Tyler913/LLM_Accelerator/Source/QMAP_FORMAT.md

# QMAP Format

Current status: QMAP v1 is the deployed descriptor contract in the
board-validated full28 design. Its runtime has 281 packets, is packed into 61
verified PL-DDR segments, and is checked for provenance, aperture safety,
non-overlap, and zero initialization of all 397 accelerator-writable regions.
The 2026-08-08 physical board launcher loaded all `61/61` segments, checked all
`281/281` QMAP headers, and reported the exact fixed two-token full28 result
`374 -> 28458 -> 64`, with expected Q26 scores, all 28 layers complete on both
steps, and no reported layer error. Subsequent UART and QWEB prompt-to-text
acceptance is recorded in `Source/CURRENT_STATE.md`.

The preserved 2026-08-01 self-contained package still records release state
`BOARD_TEST_READY_NOT_YET_HARDWARE_VALIDATED`. That value is intentionally
retained as the package's pre-board readiness state; it is not the current
project hardware-validation status. The 2026-08-08 result by itself was a
board PASS for the packaged fixed token-ID smoke; later prompt-to-text evidence
is a separate, stronger validation gate.

Historical progression through 2026-07-13: the dot64 image and the full
row1024 image both passed PS load/readback and PL AXI-master read/compute
hardware smoke tests. The first Layer 0 QKV projection work packet, local PL write-back path,
AXI write adapter, downstream local attention through `o_proj`,
post-attention residual/RMSNorm hookup, MLP gate/up projection, MLP
SiLU/multiply, MLP down projection, and final MLP residual add now pass Icarus
simulation. The full-model current-token final RMSNorm stage also passes
Icarus simulation, and the first tiled Q4 LM-head scan plus greedy argmax stage
passes Icarus simulation for a 1024-row scan window. A memory-backed
LM-head tile reader/wrapper, runtime tile scheduler, and QMAP descriptor-backed
LM-head wrapper now also pass local multi-window scans for `64` and `23`
tiles plus the full `9496`-tile vocabulary sweep. The first QMAP final-token
tail wrapper now composes final RMSNorm write-back with full-vocabulary
LM-head argmax in local RTL/xsim. The first QMAP attention front-end wrapper
now also passes local RTL simulation, reading Q/K/V projection outputs plus
q/k gamma and RoPE tables through descriptors and writing exact K/V cache plus
Q RoPE outputs. The next QMAP attention score/value wrapper now also passes
local RTL simulation, reading Q RoPE plus K/V cache and writing exact
`attn_out[2048]`. The QMAP `o_proj` wrapper now consumes that attention
output, persistent Layer 0 Q4 `o_proj` weight/scale descriptors, and writes
exact `o_proj_out[1024]` locally. The QMAP post-attention residual/RMSNorm
wrapper now consumes residual input, that `o_proj_out[1024]`, and signed
post-attention gamma, then writes exact post-attention hidden and post-norm
buffers locally. The QMAP MLP gate/up wrapper now consumes descriptor-visible
`post_norm[1024]`, persistent Q4 gate/up weight/scale descriptors, and writes
exact gate/up `[3072]` buffers locally for Layer 0 and true Layer 1 packet
instances. The QMAP MLP SiLU/multiply
wrapper now consumes descriptor-visible gate/up `[3072]` plus a fixed UQ0.16
sigmoid LUT and writes exact `mlp_hidden[3072]` locally for Layer 0 and true
Layer 1 packet instances. The QMAP MLP down wrapper now consumes
descriptor-visible `mlp_hidden[3072]`, reads persistent per-layer Q4 down-proj
weight/scale rows, and writes exact `down_out[1024]` locally for Layer 0 and
true Layer 1 packet instances. The QMAP final
MLP residual wrapper now consumes descriptor-visible
`post_attn_hidden[1024]` and `down_out[1024]`, then writes exact
`layer_out[1024]` locally. The first local Layer 0 body scheduler now chains
the QMAP post-attention residual/RMSNorm through final MLP residual wrappers
behind one memory interface and proves exact chained write-back through
`layer_out[1024]`. The wider local Layer 0 scheduler now chains attention
front-end, attention score/value, `o_proj`, and that body scheduler behind one
memory interface, proving exact K/V cache, Q RoPE, attention, `o_proj`, MLP,
and final layer write-back locally. The first local Layer 0 compute scheduler
now runs full QKV projection before that wider scheduler, patches the attention
front-end Q/K/V inputs to the produced Q/K/V output buffers, and proves exact
QKV-through-`layer_out[1024]` write-back locally. The first local
one-token/layer-loop boundary now wraps that Layer 0 compute scheduler with the
future per-layer base-table loop contract, proves the supported Layer 0 case,
proves a focused true Layer 0 -> Layer 1 run with layer done mask `0x3`, and
proves no-memory invalid-table and unsupported-loop exits locally. True Layer 1
QKV projection packets pass the same local AXI-backed write-back contract, the
attention front-end packet passes exact K/V cache plus Q RoPE write-back, the
attention score/value packet passes exact K/V cache reads plus
`attn_out[2048]` write-back, and the true Layer 1 `o_proj` packet passes exact
persistent weight/scale reads plus `o_proj_out[1024]` write-back locally. The
true Layer 1 post-attention residual/RMSNorm packet also passes exact
post-attention hidden and post-norm write-back locally. The true Layer 1 MLP
gate/up and MLP SiLU/multiply packets pass exact gate/up and
`mlp_hidden[3072]` write-back locally, and the true Layer 1 MLP down packet
passes exact persistent row reads plus `down_out[1024]` write-back locally.
The true Layer 1 final MLP residual packet also passes exact
`layer_out[1024]` write-back locally. The reusable one-token top/control
boundary now also passes both the focused Layer 2 scheduler -> final-token tail
xsim run and a stronger Layer 1 -> Layer 2 -> final-token tail xsim run with
one shared memory port, returning token `537` and score `850086863` from the
input-RMSNorm-enabled scheduler-written Layer 2 output. The standalone
per-layer input RMSNorm QMAP wrapper now also passes descriptor-backed local
RTL, reading `hidden[1024]` plus signed `I16_Q8_7` input-layernorm gamma and
writing exact `input_norm[1024]`; the Layer 0 compute scheduler and top have
focused local prechecks showing QKV consuming that wrapper-written activation
buffer. Layer 1 and Layer 2 chained artifacts now include their own input
RMSNorm packets and QKV descriptors that point at those runtime output buffers.

For Q4 quantization semantics, read `Source/Q4_FORMAT.md`. For physical PL
DDR4 placement, read `Source/FPGA_MEMORY_MAP.md`.

## Purpose

QMAP is the project's descriptor-based memory-map format for tensors stored in
PL DDR4. It is designed so the first tiny bring-up case and the later full
model use the same structure:

```text
QMAP header
tensor descriptor table
payload data
```

The first QMAP instances describe real Qwen3 Layer 0 `q_proj` data: first row
0 group 0 as a dot64 vector, then row 0 as a complete row1024 GEMV. The
long-term direction is not to keep making one-off test packets. QMAP should
become the stable descriptor contract between:

- persistent model artifacts stored once in PL DDR4
- runtime work packets that tell PL which tensors to read and which buffers to
  write for the current kernel or token step
- optional debug/golden tensors used only during bring-up

QMAP describes where data is and how to interpret it. It does not define the
math for Q4 itself; that contract stays in `Source/Q4_FORMAT.md`.

## Design Rules

- All multi-byte fields are little-endian.
- All addresses are byte addresses.
- PL DDR4 physical addresses must use 64-bit fields.
- Descriptor and payload addresses should be at least 4-byte aligned.
- Payloads used by future burst readers should be aligned to 64 bytes or
  better when practical.
- Descriptors should describe logical tensor shape separately from physical
  byte size. This matters for packed Q4 weights, where logical shape can be
  `[rows, cols]` while physical row width is `cols / 2` bytes.
- Debug/golden tensors are allowed in QMAP, but they must be marked with a
  debug flag so the future inference path can ignore them.

## Header

The QMAP header lives at the base of a QMAP image. The dot64 test-vector QMAP
image is placed at `0x4_1B10_0000`, the start of the draft PL DDR4 test-vector
staging region. The row1024 test-vector QMAP image is placed at
`0x4_1B20_0000`.

Header size: 256 bytes.

| Offset | Type | Field | Description |
| ---: | --- | --- | --- |
| `0x00` | `u32` | `magic` | ASCII `QMAP`, stored as `0x50414D51` |
| `0x04` | `u32` | `version` | Format version, current value `1` |
| `0x08` | `u32` | `header_bytes` | Current value `256` |
| `0x0C` | `u32` | `descriptor_bytes` | Current value `128` |
| `0x10` | `u32` | `descriptor_count` | Number of valid descriptors |
| `0x14` | `u32` | `descriptor_capacity` | Number of descriptor slots reserved in this image |
| `0x18` | `u64` | `descriptor_table_addr` | Physical address of descriptor table |
| `0x20` | `u64` | `payload_base_addr` | First payload byte address |
| `0x28` | `u64` | `image_base_addr` | Physical base address of the QMAP image |
| `0x30` | `u64` | `image_bytes` | Total bytes occupied by this QMAP image |
| `0x38` | `u32` | `flags` | Image-level flags, initially `0` |
| `0x3C` | `u32` | `checksum32` | Optional checksum over descriptors and payload; `0` if unused |
| `0x40` | `u32[48]` | `reserved` | Must be written as zero |

Bring-up images should reserve eight descriptor slots even if only a few are
valid. This keeps the payload base stable and leaves room for adding an output
or debug descriptor without changing the image shape.

Formal runtime work packets should reserve more descriptor slots from the
start. The first Layer 0 QKV projection packet should use at least 32
descriptor slots, with the payload base moved after the larger descriptor
table. A full persistent model manifest may use hundreds of descriptors.

Recommended first image base:

```text
qmap_base              = 0x4_1B10_0000
descriptor_table_addr  = qmap_base + 0x0100
descriptor_capacity    = 8
payload_base_addr      = qmap_base + 0x0500
```

Recommended second image base:

```text
qmap_base              = 0x4_1B20_0000
descriptor_table_addr  = qmap_base + 0x0100
descriptor_capacity    = 8
payload_base_addr      = qmap_base + 0x0500
```

## Tensor Descriptor

Each tensor descriptor is 128 bytes. Descriptors are fixed-size so PS software
and simple PL readers can index them directly:

```text
descriptor_addr = descriptor_table_addr + tensor_slot * 128
```

| Offset | Type | Field | Description |
| ---: | --- | --- | --- |
| `0x00` | `u32` | `tensor_id` | Stable id inside this QMAP image |
| `0x04` | `u32` | `role` | Tensor role enum |
| `0x08` | `u32` | `dtype` | Data type enum |
| `0x0C` | `u32` | `rank` | Number of valid dimensions in `dims` |
| `0x10` | `u32` | `flags` | Tensor flags |
| `0x14` | `u32` | `element_bits` | Logical element width in bits; use `4` for Q4 logical values |
| `0x18` | `u32` | `group_size` | Q4 group size or `0` if not grouped |
| `0x1C` | `u32` | `scale_tensor_id` | Matching scale tensor id, or `0xFFFF_FFFF` if none |
| `0x20` | `u64` | `base_addr` | Physical byte address of payload |
| `0x28` | `u64` | `nbytes` | Physical payload byte count |
| `0x30` | `u32[4]` | `dims` | Logical tensor dimensions |
| `0x40` | `u64[4]` | `strides_bytes` | Physical byte strides for each logical dimension |
| `0x60` | `u32` | `aux0` | Role-specific metadata, initially matrix id when useful |
| `0x64` | `u32` | `aux1` | Role-specific metadata, initially layer index when useful |
| `0x68` | `u32` | `aux2` | Role-specific metadata, initially row start when useful |
| `0x6C` | `u32` | `aux3` | Role-specific metadata, initially group/column start when useful |
| `0x70` | `u32` | `checksum32` | Optional tensor payload checksum; `0` if unused |
| `0x74` | `u32[3]` | `reserved` | Must be written as zero |

## Role Enum

| Value | Name | Meaning |
| ---: | --- | --- |
| `0` | `QMAP_ROLE_UNUSED` | Unused descriptor slot |
| `1` | `QMAP_ROLE_ACTIVATION` | Activation/input vector |
| `2` | `QMAP_ROLE_Q4_WEIGHT` | Packed Q4 weight tensor |
| `3` | `QMAP_ROLE_Q4_SCALE` | Per-group scale tensor |
| `4` | `QMAP_ROLE_OUTPUT` | Kernel output tensor |
| `5` | `QMAP_ROLE_EXPECTED` | Debug/golden expected tensor |
| `6` | `QMAP_ROLE_METADATA` | Extra metadata payload |
| `7` | `QMAP_ROLE_KV_CACHE` | KV cache tensor |
| `8` | `QMAP_ROLE_ROPE_TABLE` | RoPE cos/sin tensor |
| `9` | `QMAP_ROLE_PARAMETER` | Small read-only model parameter such as RMSNorm gamma or LUT |

## Dtype Enum

| Value | Name | Meaning |
| ---: | --- | --- |
| `0` | `QMAP_DTYPE_UNUSED` | Unused |
| `1` | `QMAP_DTYPE_U8` | Unsigned 8-bit integer |
| `2` | `QMAP_DTYPE_I8` | Signed 8-bit integer |
| `3` | `QMAP_DTYPE_U16` | Unsigned 16-bit integer |
| `4` | `QMAP_DTYPE_I16` | Signed 16-bit integer |
| `5` | `QMAP_DTYPE_U32` | Unsigned 32-bit integer |
| `6` | `QMAP_DTYPE_I32` | Signed 32-bit integer |
| `7` | `QMAP_DTYPE_U64` | Unsigned 64-bit integer |
| `8` | `QMAP_DTYPE_I64` | Signed 64-bit integer |
| `16` | `QMAP_DTYPE_PACKED_Q4_S4` | Two signed int4 values per byte |
| `17` | `QMAP_DTYPE_U16_Q2_14` | Unsigned 16-bit fixed-point `Q2.14` |
| `18` | `QMAP_DTYPE_I16_Q4_12` | Signed 16-bit fixed-point `Q4.12` |
| `19` | `QMAP_DTYPE_I32_Q12_12` | Signed `Q12.12` value padded to 32 bits |
| `20` | `QMAP_DTYPE_I32_Q14_10` | Signed `Q14.10` value padded to 32 bits |
| `21` | `QMAP_DTYPE_U16_Q8_8` | Legacy unsigned `UQ8.8` gamma value |
| `22` | `QMAP_DTYPE_I16_Q8_7` | Signed `Q8.7` gamma value for RMSNorm and q_norm/k_norm |
| `23` | `QMAP_DTYPE_I16_Q1_15` | Signed `Q1.15` value for RoPE cos/sin |
| `24` | `QMAP_DTYPE_U32_Q0_20` | Unsigned `UQ0.20` value padded to 32 bits |
| `25` | `QMAP_DTYPE_U16_Q0_16` | Unsigned `UQ0.16` value padded to 32 bits |

## Tensor Flags

| Bit | Name | Meaning |
| ---: | --- | --- |
| `0` | `QMAP_TENSOR_F_ROW_MAJOR` | Logical tensor is row-major |
| `1` | `QMAP_TENSOR_F_PACKED_Q4_LOW_EVEN` | Even logical Q4 index is stored in low nibble |
| `2` | `QMAP_TENSOR_F_READ_ONLY` | PL should only read this tensor |
| `3` | `QMAP_TENSOR_F_WRITE_ONLY` | PL is expected to write this tensor |
| `4` | `QMAP_TENSOR_F_DEBUG_ONLY` | Debug/golden data, not needed for inference |

## Descriptor Aux Convention

The fixed descriptor fields should be enough for simple PL readers. The `aux`
fields provide a small amount of role-specific metadata without changing the
128-byte descriptor size:

| Field | Default Meaning |
| --- | --- |
| `aux0` | matrix id or tensor-family id |
| `aux1` | layer index |
| `aux2` | row start, head index, or buffer index depending on role |
| `aux3` | group start, column start, or position start depending on role |

Do not make PL depend on descriptor slot number as the semantic meaning. Slot
number is only a table index. Tensor identity comes from `tensor_id`, `role`,
`aux`, and shape metadata.

## Matrix Ids

Matrix ids are optional descriptor metadata used by early software and debug
flows. They are not a replacement for `tensor_id`.

| Value | Name |
| ---: | --- |
| `1` | `q_proj` |
| `2` | `k_proj` |
| `3` | `v_proj` |
| `4` | `o_proj` |
| `5` | `gate_proj` |
| `6` | `up_proj` |
| `7` | `down_proj` |
| `8` | `embed_lm_head` |

## First Instance: Dot64 Smoke

The first QMAP image should describe the real Qwen3 Layer 0
`q_proj` row 0 group 0 dot64 vector from:

```text
artifacts/test_vectors/qwen3_0p6b_q4_v0/q_proj_row0_group0_dot64.npz
```

This image is a minimal descriptor instance, not a special one-off packet.

Recommended placement:

```text
qmap_base      = 0x4_1B10_0000
payload_base   = 0x4_1B10_0500
image_bytes    = 0x0000_0600
```

Descriptor table:

| Tensor Id | Role | Dtype | Shape | Payload Address | Bytes | Notes |
| ---: | --- | --- | --- | ---: | ---: | --- |
| `1` | activation | `I16_Q4_12` | `[64]` | `0x4_1B10_0500` | 128 | activation slice for columns 0..63 |
| `2` | Q4 weight | `PACKED_Q4_S4` | `[1, 64]` logical | `0x4_1B10_0580` | 32 | `q_proj` row 0, group 0 |
| `3` | Q4 scale | `U16_Q2_14` | `[1, 1]` | `0x4_1B10_05A0` | 2 | scale for row 0 group 0 |
| `4` | expected | `I64` | `[2]` | `0x4_1B10_05C0` | 16 | debug-only partial sum and scaled Q26 sum |

For packed Q4 tensors, the innermost logical dimension is sub-byte. In QMAP
v1, set `strides_bytes[0]` to the physical row stride and set the packed
innermost byte stride to `0`; the `PACKED_Q4_S4` dtype plus
`QMAP_TENSOR_F_PACKED_Q4_LOW_EVEN` flag define how logical columns map to
nibbles.

Expected descriptor metadata:

```text
tensor 1:
  aux0 = 1      # q_proj
  aux1 = 0      # layer index
  aux2 = 0      # row start
  aux3 = 0      # group start

tensor 2:
  aux0 = 1      # q_proj
  aux1 = 0
  aux2 = 0
  aux3 = 0
  group_size = 64
  scale_tensor_id = 3

tensor 3:
  aux0 = 1
  aux1 = 0
  aux2 = 0
  aux3 = 0

tensor 4:
  flags includes QMAP_TENSOR_F_DEBUG_ONLY
```

Hardware validation:

- Apps: `qmap_load_smoke_app`, then `qmap_pl_compute_smoke_app`.
- Durable sources:
  `FPGA_Project/software/qmap_load_smoke/` and
  `FPGA_Project/software/qmap_pl_compute_smoke/`.
- Image base: `0x4_1B10_0000`.
- Image size: 1536 bytes / `0x600`.
- Image SHA256:
  `b56319cf576fe8486e3586ee49a4194323cdfe4f4e6208c8b6057e741e5978d4`.
- Result: PS wrote the image into PL DDR4, read it back byte-for-byte, and
  checked the header, four descriptor slots, and selected payload values.
- PL master result: PS loaded the same image, started
  `qmap_dot64_axi_smoke_0`, and PL read the QMAP image from real PL DDR4
  through AXI. The board run reported status `0xA`, partial sum `0x60AF`,
  and scaled Q26 sum `0x2E1366`.

## Second Instance: Row1024 Smoke

The second QMAP image extends the same descriptor structure from one dot64
group to one complete Layer 0 `q_proj` output row. It is still a smoke image,
but it is the first descriptor-driven shape that matches a real GEMV row:

```text
row_sum_q26 =
  sum_group0_to_15(
    sum_j activation[group*64+j] * q4_weight[row, group*64+j]
    * scale_q2_14[row, group]
  )
```

Recommended placement:

```text
qmap_base      = 0x4_1B20_0000
payload_base   = 0x4_1B20_0500
image_bytes    = 0x0000_1000
```

Descriptor table:

| Tensor Id | Role | Dtype | Shape | Payload Address | Bytes | Notes |
| ---: | --- | --- | --- | ---: | ---: | --- |
| `1` | activation | `I16_Q4_12` | `[1024]` | `0x4_1B20_0500` | 2048 | full normalized activation vector |
| `2` | Q4 weight | `PACKED_Q4_S4` | `[1, 1024]` logical | `0x4_1B20_0D00` | 512 | `q_proj` row 0, all 16 groups |
| `3` | Q4 scale | `U16_Q2_14` | `[1, 16]` | `0x4_1B20_0F00` | 32 | one scale per 64-column group |
| `4` | expected | `I64` | `[1]` | `0x4_1B20_0F40` | 8 | debug-only expected row Q26 sum |

Expected descriptor metadata:

```text
tensor 1:
  aux0 = 1      # q_proj
  aux1 = 0      # layer index
  aux2 = 0      # row start
  aux3 = 0      # group start

tensor 2:
  aux0 = 1      # q_proj
  aux1 = 0
  aux2 = 0
  aux3 = 0
  group_size = 64
  scale_tensor_id = 3
  strides_bytes[0] = 512
  strides_bytes[1] = 0

tensor 3:
  aux0 = 1
  aux1 = 0
  aux2 = 0
  aux3 = 0
  strides_bytes[0] = 32
  strides_bytes[1] = 2

tensor 4:
  flags includes QMAP_TENSOR_F_DEBUG_ONLY
```

The row1024 smoke reader must not assume that one tensor fits in one AXI
burst. With a 32-bit AXI data path, the bring-up RTL now fetches the payload in
4-group batches so that the PL does not need to buffer the full 1024-wide row at
once.

Local validation:

- Exporter: `Qwen3-0.6B-Base/python_each_module/20_export_qmap_row1024_image.py`.
- Binary image: `artifacts/test_vectors/qwen3_0p6b_qmap_v1/q_proj_row0_row1024.qmap.bin`.
- Simulation hex:
  `FPGA_Project/sim/vectors/qmap_row1024_image_words32.hex`.
- Image SHA256:
  `2065fb798848e2779847f2b2055bb6ce51b50fd23547e66de43aa758374a917d`.
- Expected row result:
  `row_sum_q26_int64 = -3482169`, low 32-bit word `0xFFCA_DDC7`.
- RTL simulation result:
  `qmap_row1024_compute_path.sv` passed the QMAP-backed row1024 chain.
- AXI simulation result:
  `qmap_row1024_axi_smoke_top.sv` passed with 18 AXI read bursts, status
  `0xA`, and row result `-3482169`.

Hardware validation:

- App: `qmap_row1024_pl_compute_smoke_app` in the clean short-path Vitis
  workspace, with durable source kept under
  `FPGA_Project/software/qmap_row1024_pl_compute_smoke/`.
- Vitis recreation path used for the passing run: short workspace `F:\vws`,
  platform `p_r1024`, application `a_r1024`.
- Image base: `0x4_1B20_0000`.
- Image size: 4096 bytes / `0x1000`.
- Image SHA256:
  `2065fb798848e2779847f2b2055bb6ce51b50fd23547e66de43aa758374a917d`.
- Result: PS wrote the image into PL DDR4, read it back byte-for-byte, and
  checked the QMAP header fields, descriptor table address, payload base, image
  base, and image size.
- PL master result: PS started the row1024 smoke top through the temporary
  control GPIO at `0xA002_0000`; PL read the QMAP image from real PL DDR4
  through AXI and reported status `0xA`. The result GPIO at `0xA003_0000`
  returned `row_sum_q26_low32=0xFFCA_DDC7` and
  `expected_row_sum_q26_low32=0xFFCA_DDC7`, both representing `-3482169`.

## From Smoke Images to Inference Packets

The dot64 and row1024 images proved the descriptor format and the PL AXI read
path. The next step is to use the same descriptor idea for real inference data
movement.

QMAP now has two intended uses:

1. Persistent model manifest
2. Runtime work packet

### Persistent Model Manifest

The persistent model manifest describes tensors that are loaded once into PL
DDR4 and reused across prompt prefill and decode:

- Q4 packed weights and Q2.14 scales for embedding/LM-head, attention
  projections, and MLP matrices
- RMSNorm gamma vectors and q/k norm gamma vectors. Current local RTL keeps
  signed-capable gamma handling for input RMSNorm, post-attention RMSNorm,
  final RMSNorm, and q_norm/k_norm. Layer 1 input RMSNorm gamma includes
  negative values, so unsigned `U16_Q8_8` is not a deployable full-layer
  default.
- optional RoPE cos/sin tables
- fixed base addresses for KV cache, activation buffers, logits/argmax
  scratch, and debug regions

For the full Qwen3-0.6B model, the manifest will likely need hundreds of
descriptors. That is acceptable because descriptor tables are fixed-size and
small compared with model weights. The header `descriptor_capacity` should be
chosen for the artifact, not kept at the bring-up value of eight.

The persistent manifest should not be regenerated per token. PS loads it
during model setup, and PL uses it as the address/shape reference for the
runtime scheduler.

### Runtime Work Packet

A runtime work packet describes one PL task or a small sequence of PL tasks.
It should not duplicate large model weights. It should point at already-loaded
weight, scale, activation, KV-cache, and output-buffer regions using absolute
PL DDR4 addresses in each descriptor.

The current pre-QKV packet is the input RMSNorm runtime packet. The first large
Q4 GEMV runtime packet is the Layer 0 QKV projection packet. Together they are
the bridge from the proven Q4 row1024 GEMV path into the real model datapath:

```text
hidden[1024]
  -> input RMSNorm -> input_norm[1024]
  -> q_proj Q4 GEMV -> q_out[2048]
  -> k_proj Q4 GEMV -> k_out[1024]
  -> v_proj Q4 GEMV -> v_out[1024]
```

The QKV packet should use 32 descriptor slots initially:

```text
descriptor_capacity    = 32
descriptor_table_addr  = qmap_base + 0x0100
payload_base_addr      = qmap_base + 0x1100
```

Only small metadata or optional debug payloads need to live inside the packet
image. Large tensors should live in the normal PL DDR4 weight, activation, or
KV-cache regions and be referenced by descriptor `base_addr`.

### Input RMSNorm Runtime Packet

The input RMSNorm packet produces the normalized activation consumed by QKV.
It closes the pre-QKV layer-stage gap as a descriptor-backed wrapper and is now
integrated as an optional pre-stage in the Layer 0 compute scheduler.

Dataflow:

```text
hidden[1024] + input_layernorm.gamma[1024]
  -> rmsnorm_1024
  -> write input_norm[1024]
```

The current Layer 0 packet base is `0x4_050A_0000`. Layer 1 and Layer 2 chained
artifact packets use `0x4_150A_0000` and `0x4_250A_0000`. Each packet reserves
eight descriptor slots, uses five active descriptors, and uses a compact
self-contained image for local simulation:

```text
descriptor_count       = 5
descriptor_capacity    = 8
descriptor_table_addr  = 0x4_050A_0100
payload_base_addr      = 0x4_050A_0500
image_bytes            = 0x0000_5000
```

Descriptor table:

| Slot | Tensor | Role | Key fields |
| ---: | --- | --- | --- |
| `0` | metadata | `QMAP_ROLE_METADATA` | `U32`, layer/position/debug metadata |
| `1` | hidden input | `QMAP_ROLE_ACTIVATION` | `I32_Q14_10`, `[1024]`, read-only, at `0x4_050A_0540` |
| `2` | input RMSNorm gamma | `QMAP_ROLE_PARAMETER` | `I16_Q8_7`, `[1024]`, read-only, stored as sign-extended 32-bit words at `0x4_050A_1540` |
| `3` | input norm output | `QMAP_ROLE_OUTPUT` | `I32_Q12_12`, `[1024]`, write-only, at `0x4_050A_2540` |
| `4` | expected input norm | `QMAP_ROLE_EXPECTED` | `I32_Q12_12`, `[1024]`, debug-only, at `0x4_050A_3540` |

Local validation:

- Exporter:
  `Qwen3-0.6B-Base/python_each_module/48_export_qmap_input_rmsnorm_image.py`.
- Binary packet:
  `artifacts/test_vectors/qwen3_0p6b_qmap_v1/input_rmsnorm_runtime.qmap.bin`.
- Simulation hex:
  `FPGA_Project/sim/vectors/qmap_input_rmsnorm_image_words32.hex`.
- Expected output hex:
  `FPGA_Project/sim/vectors/qmap_input_rmsnorm_expected_words32.hex`.
- Packet SHA256:
  `59c3243b6cc10856918c307934b9ced8651442c70492ae2fd422cb299b54f64c`.
- RTL wrapper:
  `FPGA_Project/rtl/qmap/compute/qmap_input_rmsnorm_compute_path.sv`.
- Testbench:
  `FPGA_Project/sim/tb_qmap_input_rmsnorm_compute_path.sv`.
- Current signed-gamma Icarus result: exact `1024` input-norm write words, `14` read
  requests, `2224` read-response words, one `4096`-byte output write,
  `sum_squares=589959`, `mean_square=576`, `inv_rms=2796202`, no saturation,
  request/write backpressure coverage, busy-period spurious start coverage,
  and a bad-gamma-dtype no-write error path.
- Trace audit confirms descriptor reads complete before hidden/gamma reads,
  hidden reads complete before gamma reads, gamma reads complete before
  RMSNorm/write-back, all write data completes before done, and the invalid
  descriptor path performs no writes.
- Layer 1 chained artifact generation proved why this packet uses signed gamma:
  `layer1.input_layernorm.weight` contains negative values, so the older
  unsigned `U16_Q8_8` assumption is not valid beyond the Layer 0 bring-up case.

Scheduler integration rule: the QKV activation descriptor must be patched or
generated to read the slot-3 `input_norm[1024]` write-back buffer, not an
exporter-precomputed normalized activation copy. When the activation source is
the RTL RMSNorm output, regenerate QKV golden words with
`21_export_qmap_qkv_projection_image.py --activation-hex` and pass
`--activation-base-addr` so the QKV descriptor itself points to the RMSNorm
output buffer. The old QKV golden was based on the exporter-precomputed
activation and is not the right comparison target for the chained RTL path.

### Layer 0 QKV Projection Packet

The QKV projection packet should describe these tensors:

| Tensor Id | Role | Dtype | Shape | Flags | Notes |
| ---: | --- | --- | --- | --- | --- |
| `1` | metadata | `U32` | implementation-defined | read-only | layer index, selected token position, debug controls |
| `2` | activation | `I32_Q12_12` | `[1024]` | read-only | Layer 0 normalized activation input |
| `3` | Q4 weight | `PACKED_Q4_S4` | `[2048, 1024]` logical | read-only, packed-low-even | Layer 0 `q_proj`; row stride 512 bytes |
| `4` | Q4 scale | `U16_Q2_14` | `[2048, 16]` | read-only | one scale per 64-column group for `q_proj` |
| `5` | Q4 weight | `PACKED_Q4_S4` | `[1024, 1024]` logical | read-only, packed-low-even | Layer 0 `k_proj`; row stride 512 bytes |
| `6` | Q4 scale | `U16_Q2_14` | `[1024, 16]` | read-only | one scale per 64-column group for `k_proj` |
| `7` | Q4 weight | `PACKED_Q4_S4` | `[1024, 1024]` logical | read-only, packed-low-even | Layer 0 `v_proj`; row stride 512 bytes |
| `8` | Q4 scale | `U16_Q2_14` | `[1024, 16]` | read-only | one scale per 64-column group for `v_proj` |
| `9` | output | `I32_Q12_12` | `[2048]` | write-only | Q projection output buffer |
| `10` | output | `I32_Q12_12` | `[1024]` | write-only | K projection output buffer |
| `11` | output | `I32_Q12_12` | `[1024]` | write-only | V projection output buffer |
| `12` | expected | implementation-defined | small spot-check tensor | read-only, debug-only | optional golden words or checksum for bring-up |

Descriptor links:

- tensor `3` uses `scale_tensor_id = 4`
- tensor `5` uses `scale_tensor_id = 6`
- tensor `7` uses `scale_tensor_id = 8`
- output tensors are write-only and must not be used as expected/golden data
- debug tensors must be marked `QMAP_TENSOR_F_DEBUG_ONLY`

The PL QKV projection engine should treat Q, K, and V as the same operation
over different descriptors. The matrix dimensions change, but the row GEMV
contract stays:

```text
for each output row:
  for each group of 64 input elements:
    dot64(input_norm[group], packed_q4_weight[row, group])
    scaled_sum += partial_sum * scale[row, group]
  output[row] = convert_Q26_to_Q12_12(scaled_sum)
  write output[row] to the descriptor-provided output buffer
```

This row loop is part of the real Q/K/V projection, not an additional smoke
test. The critical new hardware capability is write-back through a PL AXI
write path.

Local validation:

- Exporter:
  `Qwen3-0.6B-Base/python_each_module/21_export_qmap_qkv_projection_image.py`.
- Full packet:
  `artifacts/test_vectors/qwen3_0p6b_qmap_v1/layer0_qkv_projection.qmap.bin`.
- Full packet base: `0x4_0008_0000`.
- Full packet size: `0x0022_B000`.
- Full packet row coverage: `q_rows=2048`, `k_rows=1024`, `v_rows=1024`.
- Full packet SHA256:
  `97ce0445a9ba67879ce10093380f5287483550930e4fca2e8c2957ab9d3ea162`.
- Python proof: Q/K/V Q26 recomputation from packed Q4 weights/scales matches
  the source Q4 artifact exactly before Q26-to-I32_Q12.12 conversion.
- Maximum Q12.12 quantization difference versus the Q4 float artifact:
  Q `0.00024390220642089844`, K `0.00024396181106567383`,
  V `0.00024393200874328613`.
- Compact simulation packet:
  `artifacts/test_vectors/qwen3_0p6b_qmap_v1/layer0_qkv_projection_sim.qmap.bin`.
- Compact simulation packet size: `0x0000_4000`.
- Compact simulation row coverage: `q_rows=4`, `k_rows=2`, `v_rows=2`.
- Compact simulation packet SHA256:
  `e50f4294bad3ff852ca18d52bf5013243ec74d5f5779093691bed16a59d09097`.
- Simulation hex:
  `FPGA_Project/sim/vectors/qmap_qkv_projection_image_words32.hex`.
- Expected output hex:
  `FPGA_Project/sim/vectors/qmap_qkv_projection_expected_words32.hex`.
- RTL simulation result:
  `qmap_qkv_projection_compute_path.sv` wrote all compact Q/K/V output words
  and matched Python I32_Q12.12 expected values. The compact run used 33 read
  requests, wrote 8 output rows, and reported no error.
- AXI write adapter result:
  `axi4_write_master.sv` passed a focused 4-beat aligned AXI4 write-burst
  simulation with a valid B-channel response.
- True Layer 1 QKV result:
  `45_export_layer_qkv_q4_vectors.py` exports
  `qkv_layer1_last_token_q4.npz`, and
  `21_export_qmap_qkv_projection_image.py --layer-id 1` emits compact and full
  Layer 1 QMAP packets at `0x4_1008_0000`. The full packet size is
  `0x0022_B000`, covers `q_rows=2048`, `k_rows=1024`, `v_rows=1024`, and the
  AXI smoke top completes `8209` read bursts plus `4096` write bursts with
  status `0xA` and exact Python expected I32_Q12.12 output-word match.
- Chained input-RMSNorm QKV packets:
  `21_export_qmap_qkv_projection_image.py --activation-hex --activation-base-addr`
  now emits packets whose activation descriptor points at the producer
  RMSNorm output buffer while retaining a debug activation payload copy. The
  regenerated Layer 0 packet reads `0x4_050A_2540` and has SHA256
  `9af7ace008d2004318c895fdbc363f6efd39b78f6d7842955d8c6848ab872bb1`; Layer 1
  reads `0x4_150A_2540` with SHA256
  `0b05c61d80108266ce0af74e721f947a597c58caccd6c5e74964d40210409de3`; Layer 2
  reads `0x4_250A_2540` with SHA256
  `4580c10509ba4bed9edab9c72fc2f4150c5812b83aac71a25c7ee76cdad080a1`.

The full self-contained packet at the legacy `0x4_0008_0000` base extends
through `0x4_002A_AFFF`. It overlaps the persistent tied embedding/LM-head
weight region that starts at `0x4_0010_0000`, so the two layouts must not be
loaded concurrently. The legacy base remains useful for isolated QKV
regressions. The continuous token-driven frontend export places the same QMAP
packet contract at non-overlapping test-vector staging base `0x4_1B40_0000`
while keeping tied weights at `0x4_0010_0000`; the RTL consumes the runtime
QMAP base and requires no format change. The fresh XSim regression and
independent timing audit in
`Temp/embedding_layer0_frontend_regression/20260713_131628` match embedding
`1024`, RMSNorm `1024`, and Q/K/V `2048/1024/1024` words exactly under
backpressure.

The same descriptor contract now passes through the complete Layer 0 body.
`51_export_embedding_layer0_full_chain.py` reuses the established per-stage
exporters with a Temp-contained vector workspace, then the shared-memory
testbench patches only consumer `base_addr` fields to the preceding producer
buffers. The audited XSim run in
`Temp/embedding_layer0_full_regression/20260713_135629` checks all 16 write
kinds, exact cache addresses, exact words through final `layer_out[1024]`, and
every producer-response-before-consumer-read boundary. Scheduler traffic is
`46278/2140354` read requests/words and `6155/25600` write requests/words. The
focused scenario intentionally invalidates the final-tail gamma descriptor
after Layer 0 completes, so this result proves the complete layer but does not
claim a new LM-head result.

The current exporter can emit self-contained images for simulation and local
bring-up. In the later persistent-manifest flow, the same descriptors should
point to already-loaded weight, scale, activation, and output-buffer regions
instead of copying large model tensors into every runtime packet.

### Attention Front-End Runtime Packet

The first per-layer body runtime packet starts immediately after QKV projection
write-back. It consumes descriptor-visible Q/K/V buffers, q/k norm gamma, and
RoPE tables, then writes K/V cache entries and a Q RoPE output buffer for the
current token.

Dataflow:

```text
q_out[2048] + k_out[1024] + v_out[1024]
  + q_norm.gamma[128] + k_norm.gamma[128]
  + rope_cos[128] + rope_sin[128]
  -> qk_norm_rope_kv_cache_stage
  -> append K/V cache for one layer/position
  -> write q_rope[2048]
```

The current packet base is `0x4_0502_0000`. It reserves 16 descriptor slots,
uses ten active descriptors, and places the payload after the table at
`qmap_base + 0x0900`.

The same packet format has also been proven with true Layer 1 data at
`0x4_1502_0000`; this is a new packet instance, not a new descriptor format.

Descriptor table:

| Slot | Tensor | Role | Key fields |
| ---: | --- | --- | --- |
| `0` | metadata | `QMAP_ROLE_METADATA` | layer index, position, and debug summary |
| `1` | Q projection output | `QMAP_ROLE_ACTIVATION` | `I32_Q12_12`, `[2048]`, read-only |
| `2` | K projection output | `QMAP_ROLE_ACTIVATION` | `I32_Q12_12`, `[1024]`, read-only |
| `3` | V projection output | `QMAP_ROLE_ACTIVATION` | `I32_Q12_12`, `[1024]`, read-only |
| `4` | q_norm gamma | `QMAP_ROLE_PARAMETER` | `I16_Q8_7`, `[128]`, read-only, padded to 32-bit words in the current packet |
| `5` | k_norm gamma | `QMAP_ROLE_PARAMETER` | `I16_Q8_7`, `[128]`, read-only, padded to 32-bit words in the current packet |
| `6` | RoPE cos | `QMAP_ROLE_ROPE_TABLE` | `I16_Q1_15`, `[128]`, read-only, padded to 32-bit words in the current packet |
| `7` | RoPE sin | `QMAP_ROLE_ROPE_TABLE` | `I16_Q1_15`, `[128]`, read-only, padded to 32-bit words in the current packet |
| `8` | KV cache | `QMAP_ROLE_KV_CACHE` | `I32_Q12_12`, `[2,8,256,128]`, base `0x4_1410_0000` in the current local layout |
| `9` | Q RoPE output | `QMAP_ROLE_OUTPUT` | `I32_Q12_12`, `[2048]`, write-only |

Local validation:

- Exporter:
  `Qwen3-0.6B-Base/python_each_module/37_export_qmap_attention_frontend_image.py`.
- RTL wrapper:
  `FPGA_Project/rtl/qmap/compute/qmap_attention_frontend_compute_path.sv`.
- Testbench:
  `FPGA_Project/sim/tb_qmap_attention_frontend_compute_path.sv`.
- Icarus result: exact `2048` K/V cache write words and exact `2048`
  Q RoPE write words, `31` accepted read requests, `4944` accepted
  read-response words, `2049` accepted write requests, `4096` accepted
  write-data words, deterministic read/write backpressure, busy-period
  spurious start coverage, and an invalid RoPE-cos dtype descriptor path that
  errors with no writes.
- True Layer 1 result: `22_export_qk_norm_rope_fixed_vectors.py`,
  `23_export_kv_cache_append_vectors.py`, and
  `37_export_qmap_attention_frontend_image.py` are now parameterized for Layer
  1 vector prefixes and runtime packet bases. The Layer 1 packet at
  `0x4_1502_0000` uses position `4`, matches all `2048` K/V cache writes and
  all `2048` Q RoPE write-back words, repeats the expected `31` read requests /
  `4944` read-response words and `2049` write requests / `4096` write-data
  words, and trace-audits that cache writes complete before Q RoPE write-back.

### Attention Score/Value Runtime Packet

The next per-layer body packet consumes the Q RoPE output buffer and K/V cache
from the attention front-end path, computes current-token attention scores,
feeds them directly into softmax/value, and writes the attention output before
`o_proj`.

Dataflow:

```text
q_rope[2048] + K cache + V cache + exp_lut[257]
  -> attention_score_stage
  -> attention_softmax_value_stage
  -> write attn_out[2048]
```

The current packet base is `0x4_0503_0000`. It reserves eight descriptor slots,
uses five active descriptors, and places payload data after the table at
`qmap_base + 0x0500`.

The same packet format has also been proven with true Layer 1 data at
`0x4_1503_0000`; this is a new packet instance, not a new descriptor format.

Descriptor table:

| Slot | Tensor | Role | Key fields |
| ---: | --- | --- | --- |
| `0` | metadata | `QMAP_ROLE_METADATA` | `aux0=score_scale_q0_31`, `aux1=layer_id`, `aux2=cache_length`, `aux3=position` |
| `1` | Q RoPE input | `QMAP_ROLE_ACTIVATION` | `I32_Q12_12`, `[2048]`, read-only |
| `2` | K/V cache | `QMAP_ROLE_KV_CACHE` | `I32_Q12_12`, `[2,8,256,128]`, read-only for this packet |
| `3` | softmax exp LUT | `QMAP_ROLE_PARAMETER` | `U32_Q0_20`, `[257]`, read-only |
| `4` | attention output | `QMAP_ROLE_OUTPUT` | `I32_Q12_12`, `[2048]`, write-only |

Local validation:

- Exporter:
  `Qwen3-0.6B-Base/python_each_module/38_export_qmap_attention_score_value_image.py`.
- RTL wrapper:
  `FPGA_Project/rtl/qmap/compute/qmap_attention_score_value_compute_path.sv`.
- Testbench:
  `FPGA_Project/sim/tb_qmap_attention_score_value_compute_path.sv`.
- Icarus result: exact `10240` K-cache reads, exact `10240` V-cache reads,
  exact `2048` `attn_out` write words, `20496` accepted read requests,
  `22961` accepted read-response words, one output write request, `2048`
  accepted write-data words, read/write backpressure coverage, and an invalid
  exp-LUT dtype descriptor path that errors with no writes.
- True Layer 1 result: `24_export_attention_score_vectors.py`,
  `25_export_attention_softmax_value_vectors.py`, and
  `38_export_qmap_attention_score_value_image.py` are now parameterized for
  Layer 1 vector prefixes and runtime packet bases. The Layer 1 packet at
  `0x4_1503_0000` uses position `4`, cache length `5`, writes `attn_out[2048]`
  at `0x4_1503_2980`, matches all `10240` K reads, all `10240` V reads, and
  all `2048` attention-output words, and trace-audits that K reads finish
  before V reads and V reads finish before output write-back.

### Attention Output Projection Runtime Packet

The next per-layer body packet consumes the `attn_out[2048]` buffer written by
the attention score/value wrapper and applies that layer's `o_proj` matrix. The
large `o_proj` Q4 weight and Q2.14 scale tensors are persistent references, not
runtime-packet payload copies.

Dataflow:

```text
attn_out[2048] + persistent o_proj.weight[1024,2048]
  + persistent o_proj.scale[1024,32]
  -> q4_gemv_row_1024(INPUT_SIZE=2048)
  -> write o_proj_out[1024]
```

The current packet base is `0x4_0504_0000`. It reserves eight descriptor slots,
uses six active descriptors, and places payload data after the table at
`qmap_base + 0x0500`.
The same packet format has also been proven with true Layer 1 data at
`0x4_1504_0000`; this is a new packet instance, not a new descriptor format.

Persistent simulation layout:

```text
layer0_o_proj_weight_base = 0x4_0600_0000
layer1_o_proj_weight_base = 0x4_0700_0000
o_proj_weight_row_bytes  = 1024
o_proj_weight_full_bytes = 0x0010_0000
layer0_o_proj_scale_base  = 0x4_0610_0000
layer1_o_proj_scale_base  = 0x4_0710_0000
o_proj_scale_row_bytes   = 64
o_proj_scale_full_bytes  = 0x0001_0000
```

Descriptor table:

| Slot | Tensor | Role | Key fields |
| ---: | --- | --- | --- |
| `0` | metadata | `QMAP_ROLE_METADATA` | `U32`, `aux0=o_proj`, `aux1=layer_id`, `aux2=1024`, `aux3=2048` |
| `1` | attention output input | `QMAP_ROLE_ACTIVATION` | `I32_Q12_12`, `[2048]`, read-only |
| `2` | `o_proj` Q4 weight | `QMAP_ROLE_Q4_WEIGHT` | `PACKED_Q4_S4`, `[1024,2048]`, persistent base from descriptor; default Layer 0 uses `0x4_0600_0000` |
| `3` | `o_proj` Q2.14 scale | `QMAP_ROLE_Q4_SCALE` | `U16_Q2_14`, `[1024,32]`, persistent base from descriptor; default Layer 0 uses `0x4_0610_0000` |
| `4` | `o_proj` output | `QMAP_ROLE_OUTPUT` | `I32_Q12_12`, `[1024]`, write-only |
| `5` | expected output | `QMAP_ROLE_EXPECTED` | `I32_Q12_12`, `[1024]`, debug-only |

Local validation:

- Exporter:
  `Qwen3-0.6B-Base/python_each_module/39_export_qmap_o_proj_image.py`.
- RTL wrapper:
  `FPGA_Project/rtl/qmap/compute/qmap_o_proj_compute_path.sv`.
- Testbench:
  `FPGA_Project/sim/tb_qmap_o_proj_compute_path.sv`.
- Icarus result: exact `1024` Q4 weight-row reads, exact `1024` scale-row
  reads, exact `1024` `o_proj_out` write words, `2070` accepted read requests,
  `280992` accepted read-response words, one output write request, `1024`
  accepted write-data words, request/response/write-data backpressure coverage,
  a busy-period spurious start pulse, and an invalid Q4 weight group-size
  descriptor path that errors with no writes. The CSV trace audit confirms row
  stores run from row 0 through row 1023 before the single output write-back
  burst and that done pulses are not adjacent.
- True Layer 1 result: `26_export_o_proj_vectors.py` and
  `39_export_qmap_o_proj_image.py` are now parameterized for Layer 1 vector
  prefixes, runtime packet bases, and persistent weight/scale bases. The
  Layer 1 packet at `0x4_1504_0000` reads `attn_out[2048]` at
  `0x4_1504_0540`, reads `1024` weight rows from `0x4_0700_0000` through
  `0x4_070F_FC00`, reads `1024` scale rows from `0x4_0710_0000` through
  `0x4_0710_FFC0`, writes exact `o_proj_out[1024]` at `0x4_1504_2540`, and
  repeats the expected `2070` accepted read requests / `280992` accepted
  read-response words plus one output write request / `1024` write-data words.

### Post-Attention Residual/RMSNorm Runtime Packet

The next per-layer body packet consumes the `o_proj_out[1024]` buffer and that
layer's residual stream, applies the post-attention residual add, then applies
post-attention RMSNorm with signed `Q8.7` gamma.

Dataflow:

```text
residual_input[1024] + o_proj_out[1024] + post_attention_gamma[1024]
  -> residual_add_1024
  -> rmsnorm_1024(signed gamma)
  -> write post_attention_hidden[1024]
  -> write post_norm[1024]
```

The current packet base is `0x4_0505_0000`. It reserves and uses eight active
descriptor slots and places payload data after the table at
`qmap_base + 0x0500`. The generated local simulation image is `0x8000` bytes.
The same packet format has also been proven with true Layer 1 data at
`0x4_1505_0000`; this is a new packet instance, not a new descriptor format.

Descriptor table:

| Slot | Tensor | Role | Key fields |
| ---: | --- | --- | --- |
| `0` | metadata | `QMAP_ROLE_METADATA` | `U32`, `aux0=post_attn_residual_norm`, `aux1=layer_id`, `aux2=1024` |
| `1` | residual input | `QMAP_ROLE_ACTIVATION` | `I32_Q14_10`, `[1024]`, read-only |
| `2` | `o_proj` output input | `QMAP_ROLE_ACTIVATION` | `I32_Q12_12`, `[1024]`, read-only, `aux0=o_proj` |
| `3` | post-attention gamma | `QMAP_ROLE_PARAMETER` | `I16_Q8_7`, `[1024]`, read-only, stored as 32-bit words |
| `4` | post-attention hidden | `QMAP_ROLE_OUTPUT` | `I32_Q14_10`, `[1024]`, write-only |
| `5` | post-norm output | `QMAP_ROLE_OUTPUT` | `I32_Q12_12`, `[1024]`, write-only |
| `6` | expected hidden | `QMAP_ROLE_EXPECTED` | `I32_Q14_10`, `[1024]`, debug-only |
| `7` | expected norm | `QMAP_ROLE_EXPECTED` | `I32_Q12_12`, `[1024]`, debug-only |

Local validation:

- Exporter:
  `Qwen3-0.6B-Base/python_each_module/40_export_qmap_post_attention_residual_norm_image.py`.
- RTL wrapper:
  `FPGA_Project/rtl/qmap/compute/qmap_post_attention_residual_norm_compute_path.sv`.
- Testbench:
  `FPGA_Project/sim/tb_qmap_post_attention_residual_norm_compute_path.sv`.
- Icarus result: exact `1024` post-attention hidden write words, exact `1024`
  post-norm write words, `30` accepted read requests, `3616` accepted
  read-response words, two output write requests, `2048` accepted write-data
  words, request/response/write-data backpressure coverage, a busy-period
  spurious start pulse, and an invalid gamma dtype descriptor path that errors
  with no writes. The CSV trace audit confirms the stage-complete snapshot and
  first hidden write request occur in the same cycle, all write data completes
  before done, and normal/bad done pulses are not adjacent.
- True Layer 1 result: `27_export_post_attention_residual_norm_vectors.py`,
  `40_export_qmap_post_attention_residual_norm_image.py`, and
  `qmap_post_attention_residual_norm_compute_path.sv` now accept/validate
  per-layer packet metadata. The Layer 1 packet at `0x4_1505_0000` reads
  residual input at `0x4_1505_0540`, `o_proj_out[1024]` at `0x4_1505_1540`,
  and post-attention gamma at `0x4_1505_2540`; it writes exact
  `post_attention_hidden[1024]` at `0x4_1505_3540` and exact
  `post_norm[1024]` at `0x4_1505_4540`. The run reports
  `sum_squares=75359102`, `inv_rms=247634`, no saturation, and the same
  `30` accepted read requests / `3616` accepted read-response words plus two
  output write requests / `2048` write-data words.

### MLP Gate/Up Runtime Packet

The next per-layer body packet consumes the post-attention RMSNorm output and
computes that layer's MLP gate/up projections from persistent Q4 weight/scale
tensors.

Dataflow:

```text
post_norm[1024]
  + persistent gate_proj.weight[3072,1024] / gate_proj.scale[3072,16]
  + persistent up_proj.weight[3072,1024] / up_proj.scale[3072,16]
  -> two q4_gemv_row_1024 cores in parallel
  -> write gate[3072]
  -> write up[3072]
```

The default Layer 0 packet base is `0x4_0506_0000`. The true Layer 1 packet
base is `0x4_1506_0000`. Both use ten active descriptors, set
`descriptor_capacity=16`, and place payload data after the table at
`qmap_base + 0x0900`. The generated local simulation image is `0xE000` bytes.

Persistent simulation layout:

```text
gate_weight_base       = 0x4_0620_0000
gate_weight_row_bytes  = 512
gate_weight_full_bytes = 0x0018_0000
gate_scale_base        = 0x4_0638_0000
gate_scale_row_bytes   = 32
gate_scale_full_bytes  = 0x0001_8000
up_weight_base         = 0x4_0640_0000
up_weight_row_bytes    = 512
up_weight_full_bytes   = 0x0018_0000
up_scale_base          = 0x4_0658_0000
up_scale_row_bytes     = 32
up_scale_full_bytes    = 0x0001_8000

layer1_gate_weight_base = 0x4_0720_0000
layer1_gate_scale_base  = 0x4_0738_0000
layer1_up_weight_base   = 0x4_0740_0000
layer1_up_scale_base    = 0x4_0758_0000
```

Descriptor table:

| Slot | Tensor | Role | Key fields |
| ---: | --- | --- | --- |
| `0` | metadata | `QMAP_ROLE_METADATA` | `U32`, `aux0=mlp_gate_up`, `aux1=layer_id`, `aux2=3072`, `aux3=1024` |
| `1` | post-norm input | `QMAP_ROLE_ACTIVATION` | `I32_Q12_12`, `[1024]`, read-only |
| `2` | gate Q4 weight | `QMAP_ROLE_Q4_WEIGHT` | `PACKED_Q4_S4`, `[3072,1024]`, persistent base `0x4_0620_0000` |
| `3` | gate Q2.14 scale | `QMAP_ROLE_Q4_SCALE` | `U16_Q2_14`, `[3072,16]`, persistent base `0x4_0638_0000` |
| `4` | up Q4 weight | `QMAP_ROLE_Q4_WEIGHT` | `PACKED_Q4_S4`, `[3072,1024]`, persistent base `0x4_0640_0000` |
| `5` | up Q2.14 scale | `QMAP_ROLE_Q4_SCALE` | `U16_Q2_14`, `[3072,16]`, persistent base `0x4_0658_0000` |
| `6` | gate output | `QMAP_ROLE_OUTPUT` | `I32_Q12_12`, `[3072]`, write-only |
| `7` | up output | `QMAP_ROLE_OUTPUT` | `I32_Q12_12`, `[3072]`, write-only |
| `8` | expected gate | `QMAP_ROLE_EXPECTED` | `I32_Q12_12`, `[3072]`, debug-only |
| `9` | expected up | `QMAP_ROLE_EXPECTED` | `I32_Q12_12`, `[3072]`, debug-only |

Local validation:

- Exporter:
  `Qwen3-0.6B-Base/python_each_module/41_export_qmap_mlp_gate_up_image.py`.
- RTL wrapper:
  `FPGA_Project/rtl/qmap/compute/qmap_mlp_gate_up_compute_path.sv`.
- Testbench:
  `FPGA_Project/sim/tb_qmap_mlp_gate_up_compute_path.sv`.
- Icarus result: exact `3072` gate write words, exact `3072` up write words,
  `12314` accepted read requests, `837280` accepted read-response words, two
  output write requests, `6144` accepted write-data words,
  request/response/write-data backpressure coverage, a busy-period spurious
  start pulse, and an invalid up-scale dtype descriptor path that errors with
  no writes. The CSV trace audit confirms 3072 row completions, gate/up write
  requests at `0x4_0506_1940` and `0x4_0506_4940`, both length 12288 bytes,
  all write data completes before done, and normal/bad done pulses are not
  adjacent.
- True Layer 1 result: with vector prefix
  `layer1_mlp_gate_up_proj_stage_real`, QMAP base `0x4_1506_0000`, and
  persistent gate/up bases `0x4_0720_0000`, `0x4_0738_0000`,
  `0x4_0740_0000`, and `0x4_0758_0000`, Icarus writes exact gate/up
  `[3072]`. Trace audit confirms normal read counts of `qmap=11`,
  `activation=4`, `gate_weight=3072`, `gate_scale=3072`, `up_weight=3072`,
  and `up_scale=3072`, gate/up write requests at `0x4_1506_1940` and
  `0x4_1506_4940`, no unknown reads, zero normal error rows, and no
  invalid-path writes.

### MLP SiLU/Multiply Runtime Packet

This per-layer body packet consumes the MLP gate/up outputs and computes that
layer's MLP activation intermediate.

Dataflow:

```text
gate[3072] + up[3072] + sigmoid_lut[1025]
  -> mlp_silu_mul_stage
  -> write mlp_hidden[3072]
```

The default Layer 0 packet base is `0x4_0507_0000`. The true Layer 1 packet
base is `0x4_1507_0000`. Both use six active descriptors, set
`descriptor_capacity=16`, and place payload data after the table at
`qmap_base + 0x0900`. The generated local simulation image is `0xE000` bytes.
The sigmoid LUT uses unsigned `UQ0.16` values over `[-8, 8]` with `1/64`
spacing; each LUT entry is stored in the low 16 bits of one 32-bit DDR word.

Descriptor table:

| Slot | Tensor | Role | Key fields |
| ---: | --- | --- | --- |
| `0` | metadata | `QMAP_ROLE_METADATA` | `U32`, `aux0=mlp_silu_mul`, `aux1=layer_id`, `aux2=3072`, `aux3=1025` |
| `1` | gate input | `QMAP_ROLE_ACTIVATION` | `I32_Q12_12`, `[3072]`, read-only |
| `2` | up input | `QMAP_ROLE_ACTIVATION` | `I32_Q12_12`, `[3072]`, read-only |
| `3` | sigmoid LUT | `QMAP_ROLE_PARAMETER` | `U16_Q0_16`, `[1025]`, read-only, padded to 32-bit words |
| `4` | hidden output | `QMAP_ROLE_OUTPUT` | `I32_Q12_12`, `[3072]`, write-only |
| `5` | expected hidden | `QMAP_ROLE_EXPECTED` | `I32_Q12_12`, `[3072]`, debug-only |

Local validation:

- Exporter:
  `Qwen3-0.6B-Base/python_each_module/42_export_qmap_mlp_silu_mul_image.py`.
- RTL wrapper:
  `FPGA_Project/rtl/qmap/compute/qmap_mlp_silu_mul_compute_path.sv`.
- Testbench:
  `FPGA_Project/sim/tb_qmap_mlp_silu_mul_compute_path.sv`.
- Icarus result: exact `3072` stage input handshakes, exact `3072` stage
  output handshakes, exact `3072` hidden write words, `43` accepted read
  requests across the normal plus invalid-descriptor runs, `7585` accepted
  read-response words, one output write request, `3072` accepted write-data
  words, request/response/write-data backpressure coverage, a busy-period
  spurious start pulse, and an invalid LUT dtype descriptor path that errors
  with no writes. The normal DUT counters are `36` read requests, `7377`
  read-response words, one write request, and `3072` write words. The CSV trace
  audit confirms the hidden write request at `0x4_0507_7980`, length `12288`
  bytes, all write data completes before done, and normal/bad done pulses are
  not adjacent.
- True Layer 1 result: `29_export_mlp_silu_mul_vectors.py`,
  `42_export_qmap_mlp_silu_mul_image.py`, and the testbench now accept Layer 1
  vector prefixes and runtime QMAP bases. The Layer 1 packet at
  `0x4_1507_0000` consumes true Layer 1 gate/up `[3072]` plus the sigmoid LUT,
  writes exact `mlp_hidden[3072]` at `0x4_1507_7980`, and preserves the same
  `36` normal read requests / `7377` normal response words / one 12288-byte
  output write burst profile. Trace audit confirms normal read counts of
  `qmap=7`, `gate=12`, `up=12`, and `lut=5`, no unknown reads, zero normal
  error rows, no invalid-path writes, and monotonic output progress.

### MLP Down Runtime Packet

The next per-layer body packet consumes the MLP SiLU/multiply hidden output and
computes that layer's MLP down projection from persistent Q4 weight/scale
tensors.

Dataflow:

```text
mlp_hidden[3072]
  + persistent down_proj.weight[1024,3072] / down_proj.scale[1024,48]
  -> q4_gemv_row_1024 with INPUT_SIZE=3072
  -> write down_out[1024]
```

The default Layer 0 packet base is `0x4_0508_0000`. The true Layer 1 packet
base is `0x4_1508_0000`. Both use six active descriptors, set
`descriptor_capacity=16`, and place payload data after the table at
`qmap_base + 0x0900`. The generated local simulation image is `0x6000` bytes.

Persistent simulation layout:

```text
down_weight_base        = 0x4_0660_0000
down_weight_row_bytes   = 1536
down_weight_full_bytes  = 0x0018_0000
down_scale_base         = 0x4_0678_0000
down_scale_row_bytes    = 96
down_scale_full_bytes   = 0x0001_8000

layer1_down_weight_base = 0x4_0760_0000
layer1_down_scale_base  = 0x4_0778_0000
```

Descriptor table:

| Slot | Tensor | Role | Key fields |
| ---: | --- | --- | --- |
| `0` | metadata | `QMAP_ROLE_METADATA` | `U32`, `aux0=mlp_down`, `aux1=layer_id`, `aux2=1024`, `aux3=3072` |
| `1` | MLP hidden input | `QMAP_ROLE_ACTIVATION` | `I32_Q12_12`, `[3072]`, read-only |
| `2` | down Q4 weight | `QMAP_ROLE_Q4_WEIGHT` | `PACKED_Q4_S4`, `[1024,3072]`, persistent base from descriptor; default Layer 0 uses `0x4_0660_0000`, row stride `1536` bytes |
| `3` | down Q2.14 scale | `QMAP_ROLE_Q4_SCALE` | `U16_Q2_14`, `[1024,48]`, persistent base from descriptor; default Layer 0 uses `0x4_0678_0000`, row stride `96` bytes |
| `4` | down output | `QMAP_ROLE_OUTPUT` | `I32_Q12_12`, `[1024]`, write-only |
| `5` | expected down output | `QMAP_ROLE_EXPECTED` | `I32_Q12_12`, `[1024]`, debug-only |

Local validation:

- Exporter:
  `Qwen3-0.6B-Base/python_each_module/43_export_qmap_mlp_down_image.py`.
- RTL wrapper:
  `FPGA_Project/rtl/qmap/compute/qmap_mlp_down_compute_path.sv`.
- Testbench:
  `FPGA_Project/sim/tb_qmap_mlp_down_compute_path.sv`.
- Icarus result: exact `1024` row completions, exact `1024` output write
  words, `3098` accepted read requests across the normal plus invalid-descriptor
  runs, `421280` accepted read-response words, one output write request, `1024`
  accepted write-data words, request/response/write-data backpressure coverage,
  a busy-period spurious start pulse, and an invalid scale dtype descriptor path
  that errors with no writes. The normal DUT counters are `3091` read requests,
  `421072` read-response words, one write request, and `1024` write words. The
  CSV trace audit confirms the down output write request at `0x4_0508_3940`,
  length `4096` bytes, all write data completes before done, and normal/bad
  done pulses are not adjacent.
- True Layer 1 result: with vector prefix `layer1_mlp_down_proj_stage_real`,
  QMAP base `0x4_1508_0000`, and persistent down bases `0x4_0760_0000` and
  `0x4_0778_0000`, Icarus writes exact `down_out[1024]`. Trace audit confirms
  normal read counts of `qmap=7`, `activation=12`, `weight=2048`, and
  `scale=1024`, normal read words of `qmap=208`, `activation=3072`,
  `weight=393216`, and `scale=24576`, the single output write at
  `0x4_1508_3940`, no unknown reads, monotonic `rows_done` through `1024`, and
  an invalid scale-dtype no-write path.

### Final MLP Residual Runtime Packet

The next per-layer body packet consumes the post-attention hidden vector and the
MLP down-projection output, then computes the descriptor-selected layer's final
MLP residual add.

Dataflow:

```text
post_attn_hidden[1024] + down_out[1024]
  -> mlp_residual_add_stage
  -> write layer_out[1024]
```

The default Layer 0 packet base is `0x4_0509_0000`; the true Layer 1 packet
base is `0x4_1509_0000`. The packet uses five active descriptors, sets
`descriptor_capacity=8`, and places payload data after the table at
`qmap_base + 0x0500`. The generated local simulation image is `0x5000` bytes.

Descriptor table:

| Slot | Tensor | Role | Key fields |
| ---: | --- | --- | --- |
| `0` | metadata | `QMAP_ROLE_METADATA` | `U32`, `aux0=mlp_residual_add`, `aux1=layer_id`, `aux2=1024` |
| `1` | post-attention hidden input | `QMAP_ROLE_ACTIVATION` | `I32_Q14_10`, `[1024]`, read-only |
| `2` | MLP down output input | `QMAP_ROLE_ACTIVATION` | `I32_Q12_12`, `[1024]`, read-only |
| `3` | layer output | `QMAP_ROLE_OUTPUT` | `I32_Q14_10`, `[1024]`, write-only |
| `4` | expected layer output | `QMAP_ROLE_EXPECTED` | `I32_Q14_10`, `[1024]`, debug-only |

Local validation:

- Exporter:
  `Qwen3-0.6B-Base/python_each_module/44_export_qmap_mlp_residual_add_image.py`.
- RTL wrapper:
  `FPGA_Project/rtl/qmap/compute/qmap_mlp_residual_add_compute_path.sv`.
- Testbench:
  `FPGA_Project/sim/tb_qmap_mlp_residual_add_compute_path.sv`.
- Icarus result: exact `1024` output words, one `4096`-byte output write
  burst, request/response/write-data backpressure coverage, a busy-period
  spurious start pulse, a bad down-input dtype descriptor path with no writes,
  and a malformed payload `last` protocol path with no writes. The normal DUT
  counters are `14` read requests, `2224` read-response words, one write
  request, and `1024` write words. The full three-run test covers `27` read
  requests and `2577` read-response words. The CSV trace audit confirms the
  layer output write request at `0x4_0509_2540`, length `4096` bytes, all
  write data completes before done, and all error paths complete without
  writes.
- True Layer 1 result: with vector prefix `layer1_mlp_residual_add_stage_real`,
  QMAP base `0x4_1509_0000`, post-attention source
  `qmap_layer1_post_attention_residual_norm`, and down source
  `qmap_layer1_mlp_down`, Icarus writes exact `layer_out[1024]`. Trace audit
  confirms normal read counts of `qmap=6`, `post=4`, and `down=4`, normal read
  words of `qmap=176`, `post=1024`, and `down=1024`, the single output write at
  `0x4_1509_2540`, and bad descriptor/protocol no-write paths.

### Layer 0 Body Scheduler Composition

`FPGA_Project/rtl/qmap/scheduler/qmap_layer0_body_scheduler.sv` is the first local composition
boundary over multiple QMAP per-layer body packets. It does not introduce a new
QMAP packet format. Instead, it sequentially starts the already passing QMAP
wrappers and muxes their memory request/write interfaces onto one local memory
port.

Composition order:

```text
post_attention_residual_norm
  -> mlp_gate_up
  -> mlp_silu_mul
  -> mlp_down
  -> mlp_residual_add
```

The testbench patches downstream descriptor `base_addr` fields so later stages
read actual producer write-back buffers:

```text
post_norm output       -> MLP gate/up activation input
gate/up outputs        -> MLP SiLU/multiply inputs
mlp_hidden output      -> MLP down activation input
post_attn_hidden output -> final MLP residual post-attention input
down_out output        -> final MLP residual down input
```

Local validation:

- RTL scheduler:
  `FPGA_Project/rtl/qmap/scheduler/qmap_layer0_body_scheduler.sv`.
- Testbench:
  `FPGA_Project/sim/tb_qmap_layer0_body_scheduler.sv`.
- Icarus result: the normal chained run completes all five stage bits
  (`stage_done_mask=0x1f`, `stage_error_mask=0x00`) with `15465` read
  requests, `1270961` read-response words, seven output write bursts, and
  `13312` write-data words. The write bursts are post-attention hidden,
  post-norm, gate, up, hidden, down, and final layer output. The final write
  request is `layer_out[1024]` at `0x4_0509_2540`, length `4096` bytes.
- Error validation: corrupting the first-stage gamma dtype descriptor exits
  with `stage_error_mask=0x01`, `stage_done_mask=0x00`, and no writes.
- The CSV trace audit confirms stage order, write addresses, final `done`, and
  no-write-on-error behavior.

### Layer 0 Full Scheduler Composition

`FPGA_Project/rtl/qmap/scheduler/qmap_layer0_full_scheduler.sv` is the first local composition
boundary over the attention-side QMAP wrappers plus the Layer 0 body scheduler.
It still does not introduce a new QMAP packet format. It sequentially starts
the already passing wrappers and muxes their memory request/write interfaces
onto one local memory port.

Composition order:

```text
attention_frontend
  -> attention_score_value
  -> o_proj
  -> qmap_layer0_body_scheduler
```

The testbench patches descriptor `base_addr` fields so consumer packets read
actual producer write-back buffers:

```text
Q RoPE output       -> attention score/value Q input
attn_out[2048]      -> o_proj activation input
o_proj_out[1024]    -> post-attention residual/RMSNorm o_proj input
post_norm[1024]     -> MLP gate/up activation input
gate/up[3072]       -> MLP SiLU/multiply inputs
mlp_hidden[3072]    -> MLP down activation input
post_attn_hidden    -> final MLP residual post-attention input
down_out[1024]      -> final MLP residual down input
```

Local validation:

- RTL scheduler:
  `FPGA_Project/rtl/qmap/scheduler/qmap_layer0_full_scheduler.sv`.
- Testbench:
  `FPGA_Project/sim/tb_qmap_layer0_full_scheduler.sv`.
- Icarus result: the normal chained run completes all four top-level stage bits
  (`stage_done_mask=0xf`, `stage_error_mask=0x0`) and all five body sub-stage
  bits (`body_stage_done_mask=0x1f`, `body_stage_error_mask=0x0`) with
  `38055` read requests, `1579650` read-response words, `2058` write requests,
  and `20480` write-data words.
- Producer write-back coverage: `2048` K/V cache single-word writes,
  `2048` Q RoPE words, `2048` attention output words, `1024` `o_proj` words,
  post hidden/norm `1024/1024`, gate/up `3072/3072`, SiLU hidden `3072`, down
  output `1024`, and final layer output `1024`, all exact against Python
  golden words.
- Error validation: corrupting the first-stage attention front-end descriptor
  exits with `stage_error_mask=0x1`, `stage_done_mask=0x0`, and no writes.
- The CSV trace audit confirms the four top-level stage transitions, exact
  read/write event counts, the `2048` cache write requests, the ten non-cache
  output write requests, normal done, and no-write-on-error behavior.

### Layer 0 Compute Scheduler Composition

`FPGA_Project/rtl/qmap/scheduler/qmap_layer0_compute_scheduler.sv` is the first local
composition boundary that includes the full Layer 0 QKV projection stage. It
does not introduce a new QMAP packet format. It sequentially starts the full
QKV projection packet and the already passing Layer 0 full scheduler, then
muxes both children onto one local memory request/write interface. It now has
an optional `qmap_input_rmsnorm_compute_path.sv` pre-stage ahead of QKV; when
the input RMSNorm QMAP base is nonzero, QKV activation is patched/generated to
consume the wrapper-written `input_norm[1024]` buffer.

Composition order:

```text
optional input_rmsnorm
  -> qkv_projection
  -> qmap_layer0_full_scheduler
```

The testbench reads the Q/K/V output descriptor bases from the QKV projection
packet and patches the attention front-end packet before starting the composed
run:

```text
QKV q_out[2048] -> attention_frontend Q input
QKV k_out[1024] -> attention_frontend K input
QKV v_out[1024] -> attention_frontend V input
```

The downstream descriptor patch chain from the Layer 0 full scheduler is then
preserved unchanged:

```text
Q RoPE output    -> attention score/value Q input
attn_out[2048]   -> o_proj activation input
o_proj_out[1024] -> post-attention residual/RMSNorm o_proj input
post_norm        -> MLP gate/up input
gate/up          -> MLP SiLU/multiply inputs
mlp_hidden       -> MLP down input
down_out         -> final MLP residual input
```

Local validation:

- RTL scheduler:
  `FPGA_Project/rtl/qmap/scheduler/qmap_layer0_compute_scheduler.sv`.
- Testbench:
  `FPGA_Project/sim/tb_qmap_layer0_compute_scheduler.sv`.
- Icarus result: the normal chained run completes both outer stage bits
  (`stage_done_mask=0x3`, `stage_error_mask=0x0`), all four full-scheduler
  stage bits (`layer0_full_stage_done_mask=0xf`,
  `layer0_full_stage_error_mask=0x0`), and all five body sub-stage bits
  (`body_stage_done_mask=0x1f`, `body_stage_error_mask=0x0`). The run covers
  `46264` read requests, `2138130` read-response words, `6154` write
  requests, and `24576` write-data words.
- Producer write-back coverage: QKV writes `2048` Q rows, `1024` K rows, and
  `1024` V rows as single-word row writes. The downstream scheduler then
  writes exact K/V cache, Q RoPE, attention, `o_proj`, post-attention hidden,
  post-norm, gate, up, SiLU hidden, down, and final layer output buffers.
- Error validation: corrupting the QKV activation dtype exits in stage 0 with
  `stage_error_mask=0x1`, `stage_done_mask=0x0`, `13` read requests,
  `400` read-response words, and no writes. Corrupting an attention front-end
  descriptor exits in stage 1 after QKV has completed with
  `stage_done_mask=0x1`, `stage_error_mask=0x2`, `8220` read requests,
  `558816` read-response words, and the expected `4096` QKV writes only.
- The CSV trace audit confirms that the first downstream read from a
  QKV-produced buffer occurs `731` cycles after the final QKV V write request,
  so no downstream consumer reads Q/K/V before the producer stage has completed
  its writes.

### One-Token Layer Scheduler Boundary

`FPGA_Project/rtl/qmap/scheduler/qmap_one_token_layer_scheduler.sv` is the first local wrapper
around the eventual repeated decoder-layer loop. It does not introduce a new
QMAP packet format. Instead, it exposes the loop-control contract that the
future full one-token path needs:

```text
layer_start_index
layer_count
position
input_hidden_base_addr
output_hidden_base_addr
kv_cache_base_addr
per-layer QMAP packet base tables
one shared memory request/write interface
```

The wrapper now iterates over a requested layer range when the corresponding
per-layer table entries are populated. The current data-backed full-compute
evidence is:

```text
single-layer:    layer_start_index = 0, layer_count = 1
true two-layer:  layer_start_index = 0, layer_count = 2
Layer2-only:     layer_start_index = 2, layer_count = 1
```

The previous two-layer alias has been superseded by a focused true Layer 0 ->
Layer 1 run. Layer 0 produces its real final `layer_out[1024]`; the Layer 1
chain then consumes true Layer 1 artifacts and writes exact Layer 1
intermediate and final golden buffers. True Layer 1 QKV Q4 vectors and
compact/full QMAP packets pass the same AXI-backed write-back contract at
`0x4_1008_0000`, the attention front-end slice passes with true Layer 1 Q/K/V,
q/k gamma, RoPE, KV-cache append, and Q RoPE write-back at `0x4_1502_0000`,
and the score/value slice passes with true Layer 1 Q RoPE, K/V cache, exp LUT,
and `attn_out[2048]` write-back at `0x4_1503_0000`; the `o_proj` slice also
passes with true Layer 1 `attn_out[2048]`, persistent `o_proj` Q4
weight/scale, and `o_proj_out[1024]` write-back at `0x4_1504_0000`; the
post-attention residual/RMSNorm slice passes with true Layer 1 residual input,
`o_proj_out[1024]`, post-attention gamma, and exact post-norm write-back at
`0x4_1505_0000`; the MLP gate/up slice passes with true Layer 1
`post_norm[1024]`, persistent gate/up Q4 weight/scale, and exact gate/up
write-back at `0x4_1506_0000`; the MLP SiLU/multiply slice passes with true
Layer 1 gate/up inputs, the fixed sigmoid LUT, and exact `mlp_hidden[3072]`
write-back at `0x4_1507_0000`; the MLP down slice passes with true Layer 1
`mlp_hidden[3072]`, persistent down-proj Q4 weight/scale, and exact
`down_out[1024]` write-back at `0x4_1508_0000`; the final MLP residual slice
passes with true Layer 1 post-attention hidden, true Layer 1
`down_out[1024]`, and exact `layer_out[1024]` write-back at `0x4_1509_0000`.
Out-of-range loop requests and missing selected or ranged base-table entries
exit before any memory request or write data is issued. This keeps the
interface honest while scaling beyond two local layers. The first
multi-layer-output-to-final-tail composition is now proven locally by a
shared-memory scheduler-to-tail xsim run.

The chained-layer artifact flow is now reusable through
`Qwen3-0.6B-Base/python_each_module/47_export_chained_layer_qmap_artifacts.py`.
Layer 2 chained artifacts have been generated from the Layer 1 final
`layer_out[1024]` vector. The Layer 2 QMAP base windows are `0x4_2008_0000`
for QKV and `0x4_2502_0000` through `0x4_2509_0000` for the attention/body
stages; persistent Layer 2 body weight windows use `0x4_0800_0000` through
`0x4_0878_0000`. The current TB has a focused `+l2_only` run that preloads the
Layer 1 output, starts the scheduler at `active_layer=2`, and proves exact
Layer 2 write-back. The AXI-Lite-controlled bounded true three-layer top-to-tail
xsim now also passes with Layer 0 kept on the existing QKV-first golden chain and
Layers 1/2 using input-RMSNorm-enabled QKV artifacts.

The final-token tail packet can now consume chained layer output artifacts as
well. `32_export_final_rmsnorm_vectors.py` accepts a fixed-point Q14.10
`--input-hex`, `35_export_lm_head_full_vocab_vectors.py` accepts a Q12.12
`--activation-hex`, and `36_export_qmap_final_token_tail_image.py` accepts
`--final-norm-prefix`. With the Layer 2 chained `layer_out[1024]` vector as
the final RMSNorm input, the regenerated final-token tail packet uses
`final_rmsnorm_layer2_chained_stage_real` and
`lm_head_argmax_layer2_chained_full_vocab_real`, then passes Vivado xsim with
expected token `537`, expected score `850086863`, all `9496` LM-head tiles, all
`151936` logits, and `max_abs_logit_diff=0`.

The same chained Layer 2 output has now also been consumed directly by the
final-token tail inside one shared-memory scheduler simulation. The focused
`+l2_tail_only` xsim run starts the Layer 2 scheduler, keeps its
`layer_out[1024]` write-back in the memory model, redirects the final-tail
final-hidden descriptor to that buffer, and then runs final RMSNorm plus
full-vocabulary LM-head. The reusable `qmap_one_token_top.sv` boundary now
performs the same sequence inside RTL control using the scheduler-reported last
layer output as the default tail hidden source, with a final-hidden override
left only for debug. The input-RMSNorm-enabled `+l2_top_tail_only` run returns
token `537` and score `850086863`; the newer `+l1_l2_top_tail_only` run starts
Layer 1 and Layer 2 before the tail and returns the same token/score while
proving the final tail selects Layer 2, not the previous layer.

Local validation:

- RTL scheduler:
  `FPGA_Project/rtl/qmap/scheduler/qmap_one_token_layer_scheduler.sv`.
- Testbench:
  `FPGA_Project/sim/tb_qmap_one_token_layer_scheduler.sv`.
- Icarus result: the normal run completes one layer
  (`layers_started=1`, `layers_completed=1`, `layer_done_mask=0x1`,
  `layer_error_mask=0x0`) and preserves the Layer 0 compute totals:
  `46264` read requests, `2138130` read-response words, `6154` write
  requests, and `24576` write-data words.
- Multi-layer loop result: a focused true Layer 0 -> Layer 1 run completes
  (`layers_started=2`, `layers_completed=2`, `layer_done_mask=0x3`,
  `layer_error_mask=0x0`) with exact Layer 1 write-back and aggregate totals
  `92528` read requests, `4276260` read-response words, `12308` write
  requests, and `49152` write-data words.
- Focused Layer 2 result: `+l2_only +fastmem +notrace +progress` now enables
  Layer 2 input RMSNorm and completes at cycle `6700589` with active layer 2,
  `layer_done_mask=0x4`, `46278/2140354` reads, `6155/25600` writes,
  `mismatch_count=0`, `write_mismatches=0`, and `max_abs=0`.
- Layer2-chained final-token tail result: Vivado xsim completes the
  final-RMSNorm plus full-vocabulary LM-head tail with token `537`, score
  `850086863`, `write reqs/words = 2 / 1027`, `norm/output write words =
  1024 / 3`, `tile updates = 9496`, `checked logits = 151936`,
  `max_abs_logit_diff = 0`, and `norm write mismatches = 0`.
- Reusable top/control result: Vivado xsim `+l2_top_tail_only +fastmem
  +progress` completes the Layer 2 input-RMSNorm-enabled scheduler at cycle
  `6700589`, completes the final-token tail at cycle `50800994`, observes
  token `537` and score `850086863`, pulses `scheduler_done=1`,
  `tail_start=1`, `tail_done=1`, and `top_done=1`, reports top counters
  `131772/22807266` reads and `6157/26627` writes, tail read counts
  `4/4/4/75968/9496`, tail writes `1024/3`, and `0` final write mismatches.
- Reusable top/control multi-layer result: Vivado xsim
  `+l1_l2_top_tail_only +fastmem +progress` starts Layer 1 and Layer 2 before
  final-tail launch, completes the scheduler at cycle `13401169`, completes
  the final-token tail at cycle `57501574`, observes token `537` and score
  `850086863`, pulses `scheduler_done=1`, `tail_start=1`, `tail_done=1`, and
  `top_done=1`, reports layer done mask `0x6`, top counters
  `178050/24947620` reads and `12312/52227` writes, tail read counts
  `4/4/4/75968/9496`, tail writes `1024/3`, and `0` final write mismatches.
- MMIO-style control result: `qmap_one_token_control_regs.sv` now defines the
  local software-visible register contract for start/clear, scalar config,
  packet-base table commit, sticky status, output token/score, layer masks,
  last output/tail hidden base, and counters. Vivado xsim
  `+l1_l2_mmio_top_tail_only +fastmem +notrace +progress` launches the same
  Layer 1 -> Layer 2 -> final-tail path through register writes and completes
  with scheduler done cycle `13401430`, tail done cycle `57501835`, token
  `537`, score `850086863`, layer done mask `0x6`, tail hidden and last-layer
  output both `0x4_2509_2540`, top counters `178050/24947620` reads and
  `12312/52227` writes, tail writes `1024/3`, and `0` final write mismatches.
  This xsim proof still uses the tiny valid/ready MMIO-style contract directly;
  the AXI4-Lite wrapper now sits above the same register contract rather than
  changing any QMAP packet semantics.
- Productized wrapper smoke result: `qmap_one_token_mmio_top.sv` instantiates
  `qmap_one_token_control_regs.sv` and `qmap_one_token_top.sv` together. The
  focused Icarus testbench `tb_qmap_one_token_mmio_top.sv` drives the register
  port, starts an intentionally invalid `layer_count=0` request, observes a
  quick scheduler validation exit, reads sticky status/layer-error/counters
  back through the same register port, and proves no memory traffic is issued.
- AXI-Lite wrapper smoke result: `axi4lite_to_mmio_regs.sv` now serializes
  32-bit AXI4-Lite reads/writes into that tiny register port with focused
  AW/W ordering, stall, local reject, and downstream error coverage in
  `tb_axi4lite_to_mmio_regs.sv`. `qmap_one_token_axil_top.sv` wraps the adapter
  around `qmap_one_token_mmio_top.sv`, and `tb_qmap_one_token_axil_top.sv`
  passes the same invalid `layer_count=0` no-memory validation path through
  AXI-Lite writes/reads while preserving sticky status, layer-error, counter,
  and clear behavior. The AXI-Lite wrapper now also passes the positive
  Layer1 -> Layer2 -> final-tail xsim memory-model path through register
  writes/reads: scheduler done cycle `13402176`, tail done cycle `57502581`,
  token `537`, score `850086863`, layer mask `0x6`, top counters
  `178050/24947620` reads and `12312/52227` writes, tail writes `1024/3`, and
  `0` final write mismatches. QMAP packet/image layout is unchanged by this
  control adapter.
- Historical mixed AXI-Lite bounded three-layer baseline: the same productized
  wrapper now launches Layer 0(QKV-first) -> Layer 1 -> Layer 2 -> final-tail
  through AXI-Lite register writes/reads under `+true3_mmio_top_tail_only` plus
  `+fastmem +notrace +progress`. It completes with scheduler done cycle
  `20095284`, tail done cycle `64195689`, token `537`, score `850086863`, layer
  mask `0x7`, scheduler counters `138820/6418838` reads and `18464/75776`
  writes, top counters `224314/27085750` reads and `18466/76803` writes, tail
  writes `1024/3`, and `0` final write mismatches. Layer 0 is intentionally
  QKV-first in this older baseline.
- Continuous token-driven three-layer result: Layer 0 input-RMSNorm artifacts
  now exist, and `52_export_embedding_true3_final_chain.py` propagates the tied
  Q4 embedding output through complete Layers 0, 1, and 2 before regenerating
  final RMSNorm and the full-vocabulary tail. The AXI-Lite regression
  `Temp/embedding_true3_axil_tail_regression/20260713_145056` passes exact golden
  comparison with token/score `537/838805253`, scheduler counters
  `138834/6421062` reads and `18465/76800` writes, and aggregate top counters
  `224330/27088110` reads and `18468/78851` writes. Its independent event audit
  proves embedding response before Layer 0 reads, each layer output response
  before the next layer reads, and Layer 2 response before scheduler-done,
  tail-start, and final hidden reads. Layer 0 QKV is staged at `0x4_1B40_0000`
  so the persistent tied table remains at `0x4_0010_0000` without overlap.
- Continuous token-driven 28-layer result:
  `53_export_embedding_full28_final_chain.py` applies the same QMAP contract to
  every model layer and emits `full_chain_manifest.json` plus a physical address
  audit. The integrated layout keeps tied weights/scales at
  `0x4_0010_0000`/`0x4_04B3_0000`, uses layer block base `0x4_0500_0000` with
  `0x0084_0000` stride, body-QMAP base `0x4_1790_0000` with 1 MiB stride,
  per-layer KV cache from `0x4_1410_0000` with 2 MiB stride, and final-tail QMAP
  base `0x4_1950_0000`. The `508` audited intervals occupy
  `0x4_0010_0000..0x4_1950_3fff`, remain inside PL DDR, and do not overlap.
- `run_embedding_full_chain_axil_tail_regression.ps1` converts that manifest into
  a generated Temp-only SystemVerilog include, then runs the generic shared-memory
  testbench through AXI-Lite. Session
  `Temp/embedding_full28_axil_tail_regression/20260713_164001` passes all 28
  complete layers and the full-vocabulary tail with exact layer mask
  `0x0fffffff`, token/score `537/1155032971`, scheduler counters
  `1295784/59929912` reads and `172340/716800` writes, and aggregate counters
  `1381280/80596960` reads and `172343/718851` writes. The independent streamed
  event audit observes all `281` QMAP packets, all 28 layer responses, exact
  write-kind/address/data counts, and strict response-before-consumer ordering;
  `top_done` occurs at cycle `231727944` with zero mismatch/error events.
- PS-side register/runtime skeleton: `FPGA_Project/software/qmap_one_token_runtime/`
  now mirrors the control register offsets and table ids, including optional
  input-RMSNorm table commits, so the continuous Layer0/Layer1/Layer2 QMAP
  contract can be represented by software before the Vivado BD base address is
  assigned. `qmap_one_token_axi_top.sv` now provides the first Vivado-facing
  shell for that software contract by adapting the existing local memory port to
  AXI4 read/write masters; `tb_qmap_one_token_axi_top.sv` proves its no-memory
  validation path without issuing AXI4 memory traffic.
- Exact write-back coverage now spans the Layer 0 QKV-first path plus chained
  Layer 1 and Layer 2 packet/cache/weight windows: Q/K/V projection, K/V cache,
  Q RoPE, attention output, `o_proj`, post-attention hidden/norm, MLP gate/up,
  SiLU hidden, down output, and final `layer_out[1024]` all match the Python
  golden words in the covered local RTL paths.
- Error validation: QKV-stage invalid activation dtype and later attention
  front-end invalid descriptor paths propagate through the loop wrapper with
  the expected layer masks. A missing selected Layer 0 QKV base-table entry, a
  missing Layer 1 packet-base entry for a two-layer request, and out-of-range
  `layer_start_index=28` all exit with no read requests, no read responses, no
  write requests, and no write data. A separate validation-only testbench also
  covers zero `layer_count` and zero input-hidden base as no-memory exits.
- Progress output confirms the true two-layer run advances from active layer 0
  to active layer 1 after Layer 0 completes, then finishes with zero
  mismatches. Layer 1 unit traces are emitted for chained score/value,
  `o_proj`, post-attention residual/RMSNorm, MLP gate/up, MLP SiLU/multiply,
  MLP down, and final MLP residual-add runs.
- Trace audit for the Layer2-chained final-token tail confirms final hidden and
  gamma reads complete before final_norm writes, final_norm/weight/scale reads
  start only after the 1024-word final_norm write-back completes, token/score
  output writes occur after all LM-head tile reads, and `done` follows the
  output write.
- Trace audit for the shared scheduler-to-tail run confirms final-hidden reads
  start after scheduler completion, final_norm reads start after final_norm
  write-back, LM-head weight/scale reads complete before output writes, and the
  output write finishes before tail `done`.
- Trace audit for the reusable top/control run
  `qmap_one_token_top_layer2_input_norm_to_final_tail_trace.csv` has `307615`
  data rows and confirms tail state starts at cycle `6700591`, hidden reads start
  at `6701175` after scheduler completion, final-norm write-back completes at
  `6708411`, norm reads start at `6709001`, LM-head weight reads start at
  `6711056`, output write request/data runs at `50800983..50800986`, and top
  `done` follows
  at `50800996`.
- Trace audit for the reusable top/control multi-layer run
  `qmap_one_token_top_layer1_layer2_input_norm_to_final_tail_trace.csv` has
  `444228` data rows and confirms Layer 1 output write-back completes at cycle
  `6700579` before Layer 2 reads that buffer at cycle `9967557`, Layer 2 output
  write-back completes at cycle `13401159` before final-tail hidden reads begin
  at cycle `13401755`, final-norm write-back completes at cycle `13408995`
  before norm reads begin at cycle `13409581`, output write request/data runs
  at `57501563..57501566`, and top `done` follows at cycle `57501576`.

### LM-head Memory-Backed Scan Contract

The first LM-head memory-facing path uses the tied embedding/LM-head table as a
Q4 weight matrix with one Q2.14 scale per 64 columns. The current local vector
exporters are:

```text
Qwen3-0.6B-Base/python_each_module/33_export_lm_head_argmax_vectors.py
Qwen3-0.6B-Base/python_each_module/35_export_lm_head_full_vocab_vectors.py
```

The exported layout keeps full-vocabulary base addresses even when the local
testbench loads only the `[0,1024)` scan window:

```text
lm_head_weight_base       = 0x4_0010_0000
lm_head_weight_row_bytes  = 512
lm_head_weight_full_bytes = 0x04A3_0000
lm_head_scale_base        = 0x4_04B3_0000
lm_head_scale_row_bytes   = 32
lm_head_scale_full_bytes  = 0x004A_3000
```

`lm_head_tile_mem_reader.sv` reads one 16-row tile as eight 1024-byte packed-Q4
weight bursts plus one 512-byte scale burst. `lm_head_argmax_mem_stage.sv`
wraps that reader around `lm_head_argmax_stage.sv` without changing the argmax
core. The local memory-model testbench passes for two complete 1024-row scans:
`1152` read requests, `278528` response words, `2048` checked logits, exact
token `264`, exact score `1365150750`, and no error cycles.

`lm_head_argmax_tile_scheduler.sv` reuses that memory-backed stage as a
one-tile child engine and keeps the global best token/score across runtime tile
windows. Its default capacity is `MAX_TILES=9496`, matching the full
`151936`-row vocabulary at 16 rows per tile. The current local scheduler
testbench proves two runtime scan counts: `64` tiles for the existing
1024-row window and `23` tiles for a 368-row prefix. It matches exact token
`264`, exact score `1365150750`, and `1392` checked logits with
`max_abs_logit_diff=0`.

`34_export_qmap_lm_head_argmax_image.py` exports QMAP runtime packets for this
path. The packet base is `0x4_0500_0000`, uses six active descriptors, and
keeps the large LM-head weights/scales as persistent tensor references instead
of copying them into the runtime packet. The same descriptor contract is used
for the compact `[0,1024)` scan and the full `[0,151936)` vocabulary scan:

| Slot | Tensor | Role | Key fields |
| ---: | --- | --- | --- |
| `0` | metadata | `QMAP_ROLE_METADATA` | scan metadata and debug summary |
| `1` | final RMSNorm output | `QMAP_ROLE_ACTIVATION` | `I32_Q12_12`, `[1024]`, read-only |
| `2` | LM-head Q4 weight | `QMAP_ROLE_Q4_WEIGHT` | `PACKED_Q4_S4`, `[151936,1024]`, `aux2=scan_base`, `aux3=tile_count` |
| `3` | LM-head Q2.14 scale | `QMAP_ROLE_Q4_SCALE` | `U16_Q2_14`, `[151936,16]`, same scan aux fields |
| `4` | output token/score | `QMAP_ROLE_OUTPUT` | three `U32` words: token, score low32, score high32 |
| `5` | expected token/score | `QMAP_ROLE_EXPECTED` | debug-only copy of the three output words |

`qmap_lm_head_argmax_compute_path.sv` validates those descriptors, reads the
final RMSNorm activation, runs the scheduler, and writes
`{token, score_low32, score_high32}` to the output descriptor. Its testbench
covers descriptor-provided `64`-tile and `23`-tile scans, plus an invalid
`tile_count=0` descriptor that must raise error and perform no output write.
The compact Icarus run reports token `264`, score `1365150750`, `812` read
requests, `191984` response words, `1392` checked logits, and
`max_abs_logit_diff=0`. The full-vocabulary Vivado xsim run uses
`QMAP_LM_HEAD_TB_FULL_VOCAB` and reports `9496` tiles, `151936` checked logits,
`85475` read requests, `20664528` response words, one output write burst,
token `264`, score `1365150750`, and `max_abs_logit_diff=0`.

### Final-Token Tail Runtime Packet

The first composed one-token tail packet adds final RMSNorm in front of the
descriptor-backed LM-head scan. It is intentionally still a runtime packet, not
a persistent manifest. The packet base is `0x4_0501_0000`, uses eight active
descriptors, and keeps the large LM-head weights/scales as persistent tensor
references.

Dataflow:

```text
final_hidden[1024] + final_norm.gamma[1024]
  -> final_rmsnorm_stage
  -> write final_norm[1024] to the QMAP activation descriptor
  -> qmap_lm_head_argmax_compute_path
  -> write output token/score descriptor
```

Descriptor table:

| Slot | Tensor | Role | Key fields |
| ---: | --- | --- | --- |
| `0` | metadata | `QMAP_ROLE_METADATA` | tail metadata and debug summary |
| `1` | final-norm scratch / LM-head activation | `QMAP_ROLE_ACTIVATION` | `I32_Q12_12`, `[1024]`, written by final RMSNorm then read by LM-head |
| `2` | LM-head Q4 weight | `QMAP_ROLE_Q4_WEIGHT` | `PACKED_Q4_S4`, `[151936,1024]`, `aux2=scan_base`, `aux3=tile_count` |
| `3` | LM-head Q2.14 scale | `QMAP_ROLE_Q4_SCALE` | `U16_Q2_14`, `[151936,16]`, same scan aux fields |
| `4` | output token/score | `QMAP_ROLE_OUTPUT` | three `U32` words: token, score low32, score high32 |
| `5` | expected token/score | `QMAP_ROLE_EXPECTED` | debug-only copy of the three output words |
| `6` | final hidden input | `QMAP_ROLE_ACTIVATION` | `I32_Q14_10`, `[1024]`, read-only |
| `7` | final RMSNorm gamma | `QMAP_ROLE_PARAMETER` | `I16_Q8_7`, `[1024]`, read-only signed gamma padded to 32-bit words in the current packet |

Local validation:

- Exporter:
  `Qwen3-0.6B-Base/python_each_module/36_export_qmap_final_token_tail_image.py`.
- RTL wrapper:
  `FPGA_Project/rtl/qmap/compute/qmap_final_token_tail_compute_path.sv`.
- Testbench:
  `FPGA_Project/sim/tb_qmap_final_token_tail_compute_path.sv`.
- Compact Icarus result: `64` LM-head tiles, token `264`, score
  `1365150750`, `1024` exact final-norm write words, `1024` checked logits,
  `max_abs_logit_diff=0`, invalid gamma descriptor error path covered, and no
  stale best-result exposure.
- Full-vocabulary Vivado xsim result: `9496` tiles, `151936` checked logits,
  token `264`, score `1365150750`, `1024` final-norm write words, `3`
  token/score output words, `max_abs_logit_diff=0`, one done pulse, and zero
  error/saturation rows in the trace audit.

## Full-Model Runtime Write-Back Policy

For correctness-first inference, these runtime values should be writable in PL
DDR4, even if later optimized versions keep some of them on chip:

| Tensor Family | Shape | Suggested Dtype | Write Policy |
| --- | --- | --- | --- |
| hidden ping-pong buffers | `[1024]` | `I32_Q14_10` or `I32_Q12_12` by stage | write after embedding/layer output |
| RMSNorm output | `[1024]` | `I32_Q12_12` | QMAP input RMSNorm wrapper writes exact projection input locally; one-token scheduler prechecks cover Layer 0/1/2 RMSNorm output feeding QKV, and focused Layer 1/2 full-layer runs now use that input-normalized activation contract |
| Q projection output | `[2048]` | `I32_Q12_12` | write for q_norm/RoPE input |
| K projection output | `[1024]` | `I32_Q12_12` | write for k_norm/RoPE input |
| V projection output | `[1024]` | `I32_Q12_12` | write for KV-cache append |
| post-RoPE K cache | `[28, 8, T, 128]` | `I32_Q12_12` | append one position per layer/token |
| V cache | `[28, 8, T, 128]` | `I32_Q12_12` | append one position per layer/token |
| attention output before `o_proj` | `[2048]` | `I32_Q12_12` | QMAP score/value wrapper now writes exact `attn_out[2048]` locally |
| `o_proj_out` | `[1024]` | `I32_Q12_12` | QMAP `o_proj` wrapper now writes exact output locally |
| post-attention hidden | `[1024]` | `I32_Q14_10` | QMAP post-attention wrapper writes and validates this residual result before post-attention RMSNorm |
| MLP gate/up outputs | `[3072]` each | `I32_Q12_12` | QMAP MLP gate/up wrapper now writes exact gate/up buffers locally |
| MLP SiLU/multiply intermediate | `[3072]` | `I32_Q12_12` | QMAP MLP SiLU/multiply wrapper now writes exact hidden locally; this is the MLP down-projection input |
| MLP down output | `[1024]` | `I32_Q12_12` | QMAP MLP down wrapper now writes exact down output locally; this is the final MLP residual input |
| layer output | `[1024]` | `I32_Q14_10` | QMAP final MLP residual wrapper now writes exact layer output locally; this is the next layer input |
| final RMSNorm output | `[1024]` | `I32_Q12_12` | local RTL final-norm stage passes; LM-head input |
| logits/argmax scratch | tiled | implementation-defined | local RTL tiled argmax core, memory-backed 1024-row wrapper, runtime tile scheduler, QMAP descriptor wrapper, and full-vocab QMAP LM-head scan pass; writes final token id and token score |

Do not require all of these tensors to be stored forever. The rule is that a
formal packet must make every consumed or produced tensor explicit. Later RTL
can replace DDR write-back with streaming or on-chip buffering only after the
descriptor-level contract is clear.

The PL reader and scheduler should therefore be designed around descriptors and
tensor ids, not around a hard-coded 256-byte packet.

## Current Full28 Board Runtime

The first board-deployable QMAP runtime is generated from the complete
28-layer manifest, then packed by
`Qwen3-0.6B-Base/python_each_module/57_pack_qmap_runtime_load_plan.py`.

Release contract:

| Property | Value |
| --- | ---: |
| layer count | `28` |
| per-layer packets | `10` |
| final-tail packets | `1` |
| total QMAP headers | `281` |
| binary load segments | `61` |
| total segment bytes | `394,547,200` |
| first loaded address | `0x4_0010_0000` |
| last end-exclusive address | `0x4_1A14_0000` |
| PL DDR aperture | `0x4_0000_0000..0x4_1FFF_FFFF` |
| accelerator-writable zero regions | `397` |

The segment manifest carries SHA256 values for every binary plus SHA256
provenance for the source load plan and complete full-chain manifest. The
release audit reconstructs interval ownership, rejects overlaps or any byte
outside PL DDR, and requires the XSDB loader to contain exactly one
`dow -data -bypass-cache-sync` operation per segment. Bypassing cache
synchronization is part of the loader contract because these physical writes
target PL DDR while Cortex-A53 #0 is halted; XSDB must not attempt A53 cache
maintenance after each data chunk. The packaged launcher uses
`name =~ "PL"` as the default `QOT_DEVICE_FILTER` for selecting the FPGA to
program, while still allowing an explicit filter override when multiple JTAG
devices are present. The release audit also compares all 280 per-layer QMAP
bases and eight global addresses compiled into the Vitis model application
against that exact full-chain manifest.

QMAP-header coverage is:

```text
28 * (
  qkv + input_rmsnorm + attention_frontend + attention_score_value +
  o_proj + post_attention_norm + mlp_gate_up + mlp_silu_mul +
  mlp_down + mlp_residual_add
) + final_tail = 281
```

The 397 zero-initialized regions are deliberate:

```text
28 layers * 14 stage-output regions = 392
+ 1 complete KV-cache region
+ hidden A
+ hidden B
+ final norm scratch
+ final token/score output
= 397
```

The single cache interval covers all 28 layer slices. QMAP packets, Q4
weights/scales, gamma/LUT/RoPE inputs, and immutable metadata are loaded;
produced activations, cache entries, and final outputs are not preloaded with
golden values. This is a release-level anti-false-positive rule.

The packaged board launcher waits for DDR status `0x5`, loads all 61 segments
with cache synchronization bypassed, and reads the magic at all 281 packet
bases before starting the model ELF. Passing these checks proves that the
intended runtime was loaded; only the subsequent exact UART token/score result
proves hardware inference.

### 2026-08-08 Fixed Two-Token Board PASS

The first physical full28 run closed the complete release acceptance sequence:

- runtime load: `61/61` binary segments;
- QMAP coverage: `281/281` packet headers;
- PL DDR status: `0x5` (calibrated, UI reset released, AXI reset released);
- position 0: input token `374`, output token `28458`, winning LM-head score
  `1227344433` in signed Q26;
- position 1: input token `28458`, output token `64`, winning LM-head score
  `1015661901` in signed Q26;
- both positions: `done=1`, `err=0`, `cmd_err=0`, `layers_started=28`,
  `layers_completed=28`, `done_mask=0x0fffffff`, and `error_mask=0`;
- final UART line:
  `PASS Qwen3-0.6B full28 persistent two-token board smoke`.

The second step issued `114688` more 32-bit memory reads than the first step,
matching one additional K/V context position across 28 layers
(`28 * 2 * 16 * 128`). Together with the shared KV-cache base and consecutive
positions 0 and 1, this is board evidence that the tested second decode step
consumed retained position-0 context. It is not a byte-for-byte readback of the
entire KV cache.

This acceptance test is deliberately narrow. The PS application launches two
fixed token-ID steps; it does not accept an arbitrary text prompt, run a board
tokenizer or detokenizer, implement EOS/stop or sampling policy, or prove an
arbitrary generation length. Do not describe this milestone as general
prompt-to-text generation.

## Open Decisions

- Exact checksum algorithm for `checksum32`.
- Whether full-model QMAP images store absolute physical addresses only, or
  store relative offsets plus a runtime base address.
- Final descriptor count/capacity for the persistent full-model manifest.
- Exact tensor ids for the persistent full-model manifest.
- Whether a future DMA loader should preserve the same physical QMAP image
  layout or translate it while copying into PL DDR4.
