Tyler913/LLM_Accelerator/FPGA_Project/sim/tb_qmap_final_token_tail_compute_path.sv

`timescale 1ns/1ps
`default_nettype none

`include "qmap_defs.svh"

`ifdef QMAP_FINAL_TOKEN_TB_FULL_VOCAB
`ifndef QMAP_FINAL_TOKEN_TB_MAX_TILES
`define QMAP_FINAL_TOKEN_TB_MAX_TILES 9496
`endif
`ifndef QMAP_FINAL_TOKEN_TB_ENABLE_INVALID_RUN
`define QMAP_FINAL_TOKEN_TB_ENABLE_INVALID_RUN 0
`endif
`endif

`ifndef QMAP_FINAL_TOKEN_TB_MAX_TILES
`define QMAP_FINAL_TOKEN_TB_MAX_TILES 64
`endif

`ifndef QMAP_FINAL_TOKEN_TB_ENABLE_INVALID_RUN
`define QMAP_FINAL_TOKEN_TB_ENABLE_INVALID_RUN 1
`endif

module tb_qmap_final_token_tail_compute_path #(
    parameter int MAX_TILES          = `QMAP_FINAL_TOKEN_TB_MAX_TILES,
    parameter int ENABLE_INVALID_RUN = `QMAP_FINAL_TOKEN_TB_ENABLE_INVALID_RUN
);

    localparam int ADDR_WIDTH       = 64;
    localparam int TILE_COUNT_WIDTH = $clog2(MAX_TILES + 1);
    localparam int TILE_ROWS        = 16;
    localparam int SCAN_ROWS        = MAX_TILES * TILE_ROWS;
    localparam int INPUT_SIZE       = 1024;
    localparam int GROUP_SIZE       = 64;
    localparam int GROUP_COUNT      = INPUT_SIZE / GROUP_SIZE;
    localparam int HIDDEN_WIDTH     = 24;
    localparam int GAMMA_WIDTH      = 16;
    localparam int NORM_WIDTH       = 24;
    localparam int WEIGHT_WIDTH     = 4;
    localparam int SCALE_WIDTH      = 16;
    localparam int MEM_DATA_WIDTH   = 32;
    localparam int MAX_READ_BYTES   = 1024;
    localparam int PARTIAL_WIDTH    = NORM_WIDTH + WEIGHT_WIDTH + $clog2(GROUP_SIZE);
    localparam int SCALED_WIDTH     = PARTIAL_WIDTH + SCALE_WIDTH;
    localparam int ROW_ACC_WIDTH    = SCALED_WIDTH + $clog2(GROUP_COUNT) + 2;
    localparam int TOKEN_ID_WIDTH   = 32;
    localparam int WEIGHT_ROW_BYTES = (INPUT_SIZE * WEIGHT_WIDTH) / 8;
    localparam int SCALE_ROW_BYTES  = (GROUP_COUNT * SCALE_WIDTH) / 8;
    localparam int TILE_WEIGHT_BYTES = TILE_ROWS * WEIGHT_ROW_BYTES;
    localparam int TILE_SCALE_BYTES  = TILE_ROWS * SCALE_ROW_BYTES;
    localparam int WEIGHT_BURSTS_PER_TILE = TILE_WEIGHT_BYTES / MAX_READ_BYTES;
    localparam int SCALE_BURSTS_PER_TILE = 1;
    localparam int BURSTS_PER_TILE = WEIGHT_BURSTS_PER_TILE + SCALE_BURSTS_PER_TILE;
    localparam int WORDS_PER_TILE = (TILE_WEIGHT_BYTES + TILE_SCALE_BYTES) / 4;
    localparam int WEIGHT_BURSTS_PER_ROW = 1;
    localparam int SCALE_BURSTS_PER_ROW = 1;
    localparam int BURSTS_PER_ROW =
        WEIGHT_BURSTS_PER_ROW + SCALE_BURSTS_PER_ROW;
    localparam int WEIGHT_WORDS = SCAN_ROWS * WEIGHT_ROW_BYTES / 4;
    localparam int SCALE_WORDS = SCAN_ROWS * SCALE_ROW_BYTES / 4;
    localparam int QMAP_IMAGE_BYTES = 32'h0000_4000;
    localparam int QMAP_WORDS = QMAP_IMAGE_BYTES / 4;
    localparam int DESCRIPTOR_WORDS = 32;
    localparam int DESCRIPTOR_TABLE_WORD_OFFSET = 32'h0100 / 4;
    localparam int DESC_DTYPE_WORD = 2;
    localparam int DESC_BASE_LO_WORD = 8;
    localparam int DESC_BASE_HI_WORD = 9;
    localparam int SLOT_NORM_OUTPUT = 1;
    localparam int SLOT_OUTPUT = 4;
    localparam int SLOT_FINAL_HIDDEN = 6;
    localparam int SLOT_FINAL_GAMMA = 7;
    localparam logic [15 : 0] MAX_READ_BYTES_U16 = MAX_READ_BYTES;
    localparam logic [15 : 0] TILE_SCALE_BYTES_U16 = TILE_SCALE_BYTES;
    localparam int REGION_QMAP = 0;
    localparam int REGION_WEIGHT = 1;
    localparam int REGION_SCALE = 2;
    localparam int WRITE_KIND_NONE = 0;
    localparam int WRITE_KIND_NORM = 1;
    localparam int WRITE_KIND_OUTPUT = 2;

    logic clk;
    logic rst_n;
    logic start;
    logic busy;
    logic done;
    logic error;
    logic norm_saturation;
    logic [TOKEN_ID_WIDTH-1 : 0] best_token_id;
    logic signed [ROW_ACC_WIDTH-1 : 0] best_score_q26;
    logic [31 : 0] tiles_started;
    logic [31 : 0] tiles_completed;
    logic [31 : 0] norm_cycle_count;
    logic [31 : 0] mem_read_burst_count;
    logic [31 : 0] mem_read_word_count;
    logic [31 : 0] mem_write_word_count;
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
