Tyler913/LLM_Accelerator/(commit log)

2026-07-01 descriptor-backed wrapper validation
    [attention_score_stage_trace.csv, attention_softmax_value_stage_trace.csv, final_rmsnorm_stage_trace.csv, kv_cache_append_trace.csv, lm_head_argmax_stage_trace.csv, mlp_down_proj_stage_trace.csv, mlp_gate_up_proj_stage_trace.csv, mlp_residual_add_stage_trace.csv]
2026-08-08 successfully download the Qwen model to the board
2026-08-17 download the webUI firmware to the board and do python testing
2026-08-26 Prepare public release
    [attention_score_stage_trace.csv, attention_softmax_value_stage_trace.csv, final_rmsnorm_stage_trace.csv, kv_cache_append_trace.csv, lm_head_argmax_stage_trace.csv, mlp_down_proj_stage_trace.csv, mlp_gate_up_proj_stage_trace.csv, mlp_residual_add_stage_trace.csv]
